guruITA/smart-city-sim/docs/tile objectives.md

# Tiles

## 1. City layout
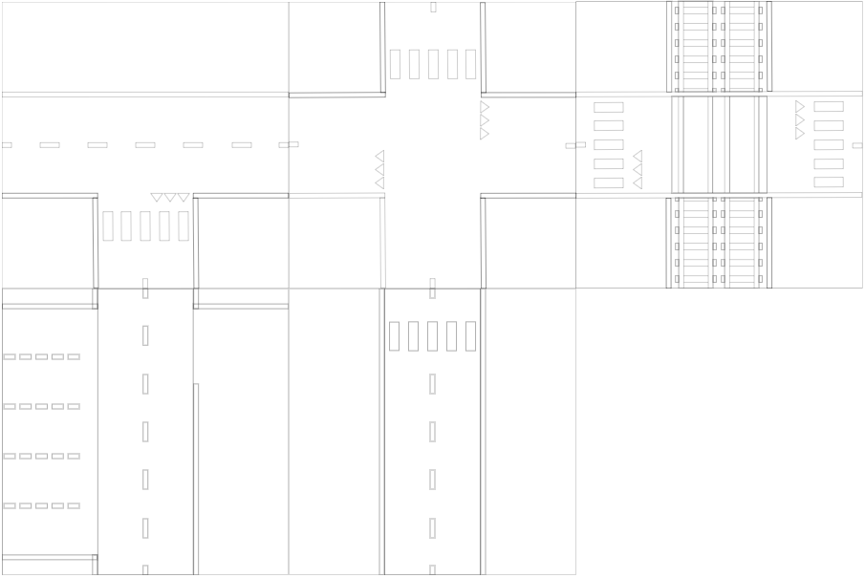
[picture p14: docs/assets/tiles city-layout.png]
City layout


---

## 2. Tile objectives
These will be the objectives everyone will focus on.

### sprint 1
- Thijmen - railroad crossing with barriers and warning lights 
- Gurpreet - Streetlights
- Wesley - Traffic lights
- Matin - Parking
- Betül - Pedestrian Light

---
