guruITA/smart-city-sim/docs/Thijmen/index.md

# Thijmen's vault

Indexes:

- [Blink RGB LED demo](./Blink%20RGB%20LED.md)

- [Blink 2 LEDS alternating demo](./Blink%202%20LEDS%20alternating.md)

- [Train prediction signal demo](./Train%20prediction%20signal%20demo.md)
