guruITA/smart-city-sim/docs/Matin/Sprint 2/Mayor Delivery.md

# Mayor Delivery - Sprint 2

## My Challenges

Deployed the backend on the Raspberry Pi (145.92.8.137) with production Docker setup, restart policies, and environment variables. Merged Thijmen's railroad crossing code into the shared backend (233 commits, 5 file-level merge conflicts resolved). Analyzed all team members' code for WiFi readiness and created a 3-phase integration plan. Backend grew to 15+ endpoints across 4 routers and 4 database tables.

## The City

Backend running on the Raspberry Pi, accessible on the HvA network. Railroad crossing tile fully integrated with dedicated database tables. Dashboard shows parking and railroad data live. Deployment script automates updates via SSH. The generic sensor readings table works for simple tiles, dedicated tables added for structured state (railroad crossing).

## Agreements Next Period

Put everything together in the city as a team. All tiles connected to the Pi, city should be complete.

## Learning Group Feedback

Mats said: I want to hear a story, the city should be done, no perfection needed, and surprise me.

## Personal Feedback

Focus on the backend and make sure the whole city works together as one system.

## Reflection

**What went well:** Pi deployment works, railroad crossing merged successfully, created an integration plan for the whole team.

**What can be improved:** Not all tiles connected yet. Portflow evidence was missing problem framing and learning goals, which caused the 1/4 score from Mats.

**What I take to the next sprint:** Technical work is invisible without a story. Next sprint: describe the problem first, then show the solution.
