guruITA/smart-city-sim/docs/Thijmen/Sprint 2/index.md

## Learning Question
How can I structure the train crossing functionality as reusable and mergeable code within one shared ESP32-S3 project, so that it can send train data to a backend and be integrated with other tiles in a clear, maintainable, and reliable way?

## Deliverables
1. [Analysis](./Analysis.md)
2. [Design](./Design.md)
3. [Realise](./Realise.md)
4. [Advice](./Advice.md)
