guruITA/smart-city-sim/docs/Thijmen/Sprint 3/index.md

## Learning Question
How can I add a screen to the ESP32 that shows the city’s name and logo, and make sure this information can be updated from the backend in a clear and reusable way?

## Deliverables
1. [Analysis](./Analysis.md)
2. [Design](./Design.md)
3. [Realise](./Realise.md)
4. [Advice](./Advice.md)
