guruITA/smart-city-sim/docs/Wesley/learning outcomes/sprint 3/Advice - Recognizing when a car is waiting at the traffic light and sending that information to the backend.md

# Advice - Recognizing when a car is waiting at the traffic light and sending that information to the backend

## Table of Contents

- [Introduction](#introduction)
- [Starting point](#starting-point)
- [Was my chosen solution suitable](#was-my-chosen-solution-suitable)
- [What worked well](#what-worked-well)
  - [1. The solution was simple enough to understand and test](#1-the-solution-was-simple-enough-to-understand-and-test)
  - [2. It fit well on top of my existing traffic-light prototype](#2-it-fit-well-on-top-of-my-existing-traffic-light-prototype)
  - [3. It helped me think in traffic states instead of raw inputs](#3-it-helped-me-think-in-traffic-states-instead-of-raw-inputs)
  - [4. It matched the broader smart-traffic direction of the project](#4-it-matched-the-broader-smart-traffic-direction-of-the-project)
- [What did not work as strongly](#what-did-not-work-as-strongly)
  - [1. It is only a simplified representation of a real road loop](#1-it-is-only-a-simplified-representation-of-a-real-road-loop)
  - [2. Sensor meaning still depends heavily on context](#2-sensor-meaning-still-depends-heavily-on-context)
  - [3. It can still be sensitive to placement](#3-it-can-still-be-sensitive-to-placement)
  - [4. It does not yet solve more advanced traffic situations](#4-it-does-not-yet-solve-more-advanced-traffic-situations)
- [Problems or limitations I found](#problems-or-limitations-i-found)
- [What I would advise for the next iteration](#what-i-would-advise-for-the-next-iteration)
  - [1. Keep the interpreted-state approach](#1-keep-the-interpreted-state-approach)
  - [2. Improve the physical placement and proof](#2-improve-the-physical-placement-and-proof)
  - [3. Add stronger validation rules in software](#3-add-stronger-validation-rules-in-software)
  - [4. Make the backend output easier to inspect](#4-make-the-backend-output-easier-to-inspect)
  - [5. Consider a more realistic traffic sensor later](#5-consider-a-more-realistic-traffic-sensor-later)
- [My final advice](#my-final-advice)
- [Conclusion](#conclusion)
- [References](#references)

## Introduction

In this advice document, I evaluate whether my chosen solution was suitable for recognizing when a car is waiting at the traffic light and sending that information to the backend.

For this learning goal, I chose to use the **KY-021 Mini Magnetic Reed Switch Module** as a simple prototype sensor. I used it to represent the function of a road loop in a simplified way. The goal of this step was not to build a full real-world traffic detection system yet, but to prove that my project can detect a traffic situation, interpret it correctly, and pass that interpreted result to the backend.

This advice builds on the wider project direction that a traffic light becomes smart when it starts reacting to real-time input instead of only following a fixed cycle. The broader second-iteration requirements already define that the system must detect vehicles, use that input in traffic-light decisions, and fall back safely if no valid input is available. 

## Starting point

Before this learning goal, I already had a working first traffic-light prototype. The first iteration already gave me a stable base with the ESP32-S3, the three traffic-light outputs, fixed phase timing, safe startup in red, and a clear implementation flow from analysis to design to realization.  The earlier Fritzing work also showed that documenting the hardware design clearly made later building and checking easier. 

That was important, because it meant I did not have to solve everything at once. I could extend an already working traffic-light system with one new smart input.

## Was my chosen solution suitable

Yes, for this iteration I think my chosen solution was suitable.

The KY-021 was a good prototype choice because it let me focus on the most important learning result of this goal:

* noticing that something is happening at the stop line
* deciding whether that means waiting traffic or not
* sending that interpreted state to the backend

For this step, I did not yet need a complex sensor. I needed a sensor that was simple enough to wire, simple enough to read, and clear enough to test. The KY-021 gave me that.

So as a **prototype learning solution**, it was suitable.

## What worked well

### 1. The solution was simple enough to understand and test

The KY-021 works with a simple digital signal. That made it easier to connect to the ESP32-S3 and easier to reason about in software. For this learning goal, that simplicity was helpful, because I wanted to focus on the interpretation logic rather than on complicated sensor calibration.

### 2. It fit well on top of my existing traffic-light prototype

Because the first iteration already worked physically and logically, I could use that earlier prototype as the base and only add the new sensor flow. That made the step realistic and manageable instead of too large at once. The earlier implementation already proved that my hardware base and traffic-light sequence were stable enough to build on. 

### 3. It helped me think in traffic states instead of raw inputs

This was the strongest part of the solution. The real learning was not that the pin can become active. The real learning was that the same sensor trigger can mean different things depending on the traffic-light phase.

Because of that, this learning goal pushed me to work with interpreted states such as:

* no vehicle
* waiting vehicle
* passing vehicle
* unclear input

That is a more useful system design than only sending raw sensor values to the backend.

### 4. It matched the broader smart-traffic direction of the project

The wider project already says that smart behavior begins when the system uses sensor input as part of traffic-light decisions. This solution fits that direction, because it is the first step where the traffic light starts responding to something happening on the road instead of only following a timer. 

## What did not work as strongly

Even though the solution was suitable for this iteration, it also has limitations.

### 1. It is only a simplified representation of a real road loop

The KY-021 is useful as a prototype stand-in, but it is not the same as a real inductive loop in a road. It depends on a magnet and a reed-switch trigger, while a real traffic loop works in a very different physical way.

That means the solution is good for learning and prototyping, but not realistic enough to claim that it fully represents real traffic detection.

### 2. Sensor meaning still depends heavily on context

The KY-021 alone does not know whether a car is waiting. It only knows whether the magnet is present. The actual meaning has to be created in software by combining:

* sensor state
* signal duration
* traffic-light phase

That means the hardware alone is not enough. The quality of the result depends strongly on the interpretation logic.

### 3. It can still be sensitive to placement

The meaning of the signal depends a lot on where the sensor is placed. If it is too early, too late, or not aligned well with the car position, it can produce a trigger that does not really represent a waiting car.

So even though the sensor is simple, correct placement is still important.

### 4. It does not yet solve more advanced traffic situations

This solution is still limited to one simple question:

**is there a waiting car here or not**

It does not yet tell me:

* how many cars are waiting
* how long the queue is
* how fast traffic is moving
* whether traffic density is increasing
* whether there are multiple vehicles in one lane

So it is a useful first smart step, but not yet a complete smart-traffic solution.

## Problems or limitations I found

The main limitation I found is that a sensor trigger by itself is not enough to describe the traffic situation clearly.

The hardest part was not detecting presence, but preventing wrong interpretation. The most important example is this:

* during red, a stable trigger can mean a waiting car
* during green, a short trigger can simply mean a passing car

That means the project can easily give the wrong answer if the sensor signal is treated too simply.

A second limitation is that the backend only becomes useful if it receives interpreted information. Sending only active or inactive would not be strong enough, because the backend would still need to guess what the signal means.

## What I would advise for the next iteration

### 1. Keep the interpreted-state approach

This is something I would definitely keep.

I would continue to send states like:

* waiting
* passing
* no vehicle
* unclear

instead of only sending raw sensor values. That makes the backend clearer and makes the whole project more understandable.

### 2. Improve the physical placement and proof

In the next iteration, I would pay even more attention to the exact stop-line position of the sensor and to the physical proof of that position in Fritzing and in the real build.

The earlier Fritzing work already showed me that good documentation improves clarity and traceability. For the next version, that will matter even more because the sensor position affects the meaning of the result. 

### 3. Add stronger validation rules in software

In a next iteration, I would improve the logic for deciding when a signal is stable enough and when it should be treated as unclear. That would reduce the risk of short, accidental, or badly timed triggers being treated as real waiting traffic.

### 4. Make the backend output easier to inspect

The backend part worked conceptually, but in a next iteration I would make the output even easier to review. For example, I would log:

* phase
* interpreted state
* time of change
* validity of the reading

That would make debugging and later analysis easier.

### 5. Consider a more realistic traffic sensor later

For this learning goal, the KY-021 was a good prototype choice. But if I want to make the system more realistic later, I should eventually look at a sensor that better matches real road detection behavior. That would make the smart part of the traffic light closer to real-world traffic systems.

## My final advice

If I had to advise myself or another student doing the same kind of project, I would say this:

Start with a simple sensor solution if the goal is to learn how the traffic light should **interpret** traffic input, not to perfectly copy real-world hardware immediately.

The KY-021 is suitable for that purpose because it keeps the setup simple and testable. But do not mistake a simple trigger for a complete traffic answer. The real value comes from combining the signal with the traffic-light phase and turning it into a meaningful state for the backend.

So my advice is:

* use a simple sensor first
* focus on interpretation logic
* keep safety and fallback behavior central
* document the hardware clearly
* improve realism only in later iterations

## Conclusion

Looking back at this learning goal, I think my chosen solution was suitable for the stage of the project I am in now.

The KY-021 was not the perfect real-world traffic sensor, but it was a good prototype choice because it allowed me to prove the most important step: my traffic-light project can move from fixed behavior to sensor-informed behavior.

The strongest part of the solution was not the sensor itself, but the decision to interpret the signal in context and send that interpreted result to the backend.

So my final conclusion is:

**For this iteration, the KY-021 was a suitable prototype solution because it was simple enough to build and test, while still allowing me to learn the more important skill of interpreting traffic input correctly and using it safely in the system.**

## References

Wesley. *Smart Traffic Light - When Does a Traffic Light Become Smart.* Used as the broader project source for second-iteration vehicle-detection requirements, smart-traffic direction, acceptance criteria, and safe fallback behavior. 

Wesley. *Traffic Light - first iteration - implementation.* Used as proof that the earlier ESP32-S3 traffic-light base was already working and suitable to extend with sensor-based behavior. 

Wesley. *Traffic Light - first iterion - fritzing.* Used as reference for the value of clear hardware documentation and traceability in the project workflow.
