guruITA/smart-city-sim/docs/Wesley/learning goals/sprint 2/Sprint 2, Learning Goal 1 - Expanding the traffic-light system to multiple traffic lights v2.md

# Sprint 2 — Learning Goal 1: Expanding the traffic-light system to multiple traffic lights

## Learning Question

How can I turn my first simple traffic light into a small crossroads system with multiple traffic lights that work together safely and clearly?

## S — Situation

At the start of Sprint 2, I already have one working traffic light. I built it with an ESP32-S3, three LEDs, and one resistor for each LED. The system starts safely on red, changes in a fixed order from red to green to yellow, and repeats that cycle correctly. I tested it in simulation and on real hardware, so I know the first version works.

That first version helped me understand the basics: how to connect the lights, how to control them, and how to make sure the system stays safe by never turning on conflicting lights at the same time. Right now, the setup only represents one traffic light. That is fine for learning the basics, but it does not yet reflect a real traffic situation. A real crossroads has more than one traffic light, and those lights must work together.

In this sprint, I want to take the next step by expanding my project from one traffic light to multiple traffic lights. The reason is practical: traffic lights are not useful on their own at a crossroads. They need to be coordinated so road users can clearly understand when they must stop and when they may go. If that coordination is wrong, the situation becomes confusing or unsafe. By adding multiple traffic lights, I move from a simple demo to a more realistic traffic situation.

## T — Task

For this learning goal, my task is to turn my first working traffic light into a small crossroads system with multiple traffic lights that can work together properly. The purpose of this step is not only to add more lights, but to make sure the full situation remains understandable and safe. I want to solve the practical problem that one traffic light on its own does not yet show how traffic control works in a real environment.

To do that, I will first work out what the expanded system needs to do and what rules it has to follow. After that, I will design how the traffic lights should be connected and how they should take turns. I will then build and test the setup, first on the breadboard and later in the project tile. During that process, I will check whether the lights work together in a logical way and whether unsafe combinations are prevented. The goal is to create a working multi-traffic-light system that is not only technically correct, but also makes sense from the perspective of real traffic use.

### Deliverables

1. Analysis document

In this document, I explain what I am adding in this second version of the project and what the crossroads system should do in practice. I describe the most important safety rules that the system has to follow so that the traffic lights work together in a clear and safe way. I also explain what I see as a correct result for this step and which limits I still have in my current hardware setup.

2. Design document

In this document, I show how the multiple traffic lights are connected and which pins and components I use for the full setup. I explain how the traffic lights are grouped and how they take turns during the traffic cycle. I also include a diagram or table that makes clear how the full system works as one coordinated setup.

3. Realisation document

In this document, I record how I first build the setup on a breadboard and how I test whether the traffic lights work together correctly. I describe how I transfer the working setup into the project tile and which code I use to control the different traffic lights. I also show the test results that prove the system works safely and as intended.

4. Advice document

In this document, I evaluate whether the system is easy to understand and whether the chosen structure is good enough for the next sprint. I reflect on the problems or limitations I ran into during this step and explain what I would improve before continuing with smarter behaviour in a later iteration.

## A — Action

I worked on this learning goal in four clear steps.

First, I made the **analysis deliverable**. In that document, I examined how I could expand my first simple traffic light into a four-way crossing with multiple traffic lights, while still keeping the system understandable, safe, and suitable for later extension. I compared possible approaches and chose the direction with an **ESP32-S3, MCP23017, two ULN2803 chips, and external LED power**, because that structure uses fewer controller pins, avoids multiplexing, and leaves room for later sensors and backend control.

After that, I made the **design deliverable**. In that document, I translated the analysis into a concrete design for the crossroads system. I worked out the grouping of the traffic lights into **North/South** and **East/West**, defined the coordinated traffic cycle, described the channel mapping, and documented the full hardware structure from controller to lamp output. I also made clear how the design stays safe by preventing conflicting green states and by using all-red transition phases.

Next, I worked on the **realisation phase**. I first used staged tests during building, starting with serial communication, then I2C communication, then standalone testing of the MCP23017, standalone testing of the ULN2803, and then the combined signal path. After that, I built the full four-way setup on the breadboard and tested whether the system started safely, followed the correct sequence, avoided conflicting green states, and cycled stably. In this phase, I also improved the software by replacing `delay()` with a `millis()` based state machine so the code is more suitable for later integration with other parts of the project.

Finally, I made the **advice deliverable**. In that document, I looked back on the choices I made and described what I should keep for the next sprint. My advice was to keep the current hardware architecture, keep the simplified crossroads model, continue with the `millis()` based approach, keep testing in stages, and add only one smart feature first in the next iteration.
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
