guruITA/smart-city-sim/docs/Wesley/learning outcomes/sprint 2/Advice — Learning Goal 1 - Expanding the traffic-light system to multiple traffic lights.md

# Advice — Learning Goal 1 - Expanding the traffic-light system to multiple traffic lights

## Table of Contents

- [1. Introduction](#1-introduction)
- [2. Advice based on this sprint](#2-advice-based-on-this-sprint)
  - [2.1 I should keep the current hardware structure](#21-i-should-keep-the-current-hardware-structure)
  - [2.2 I should keep the simplified crossroads model](#22-i-should-keep-the-simplified-crossroads-model)
  - [2.3 I should keep the `millis()` based state machine](#23-i-should-keep-the-millis-based-state-machine)
  - [2.4 I should make the software more modular before adding too much new behaviour](#24-i-should-make-the-software-more-modular-before-adding-too-much-new-behaviour)
  - [2.5 I should freeze one final mapping before continuing](#25-i-should-freeze-one-final-mapping-before-continuing)
  - [2.6 I should add only one smart feature first](#26-i-should-add-only-one-smart-feature-first)
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
