guruITA/smart-city-sim/docs/Betül/images/nietbeveiligd-docs-swagger.png

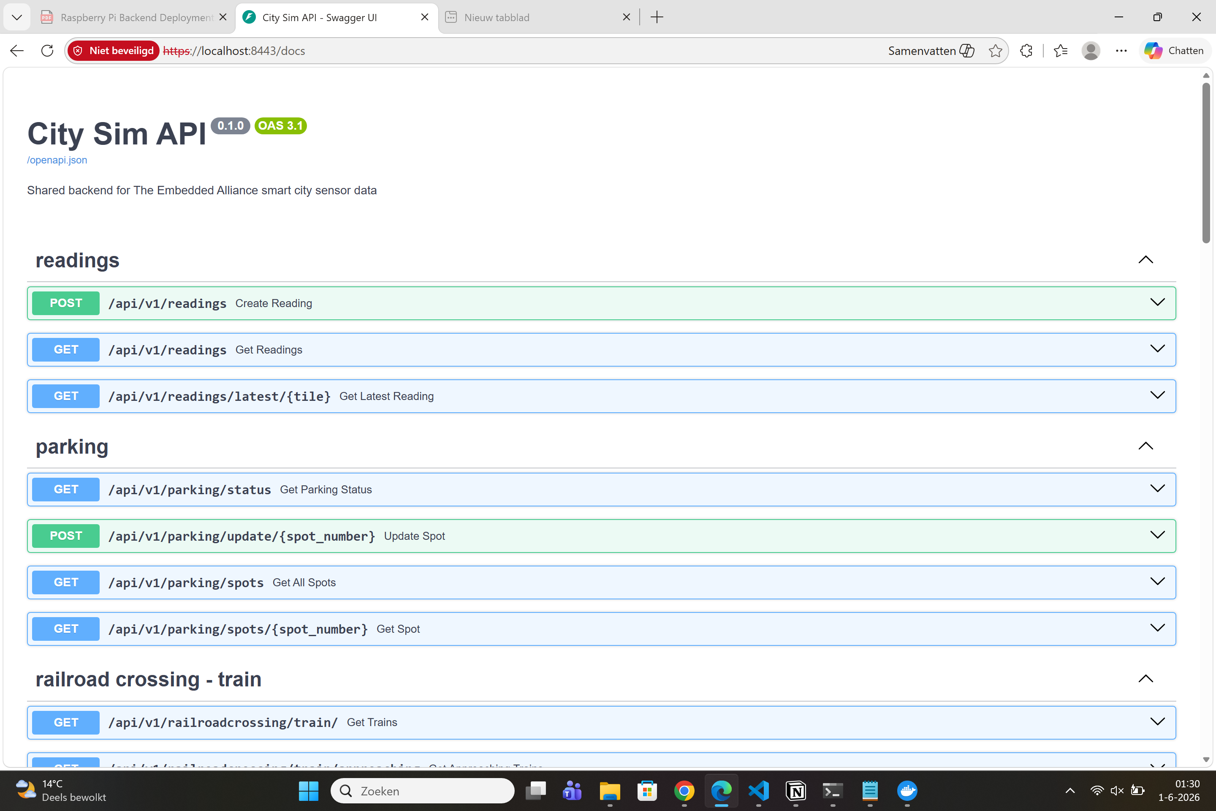
docs/Betül/images/nietbeveiligd-docs-swagger.png
