guruITA/smart-city-sim/docs/Betül/images/nietbeveiligd.png

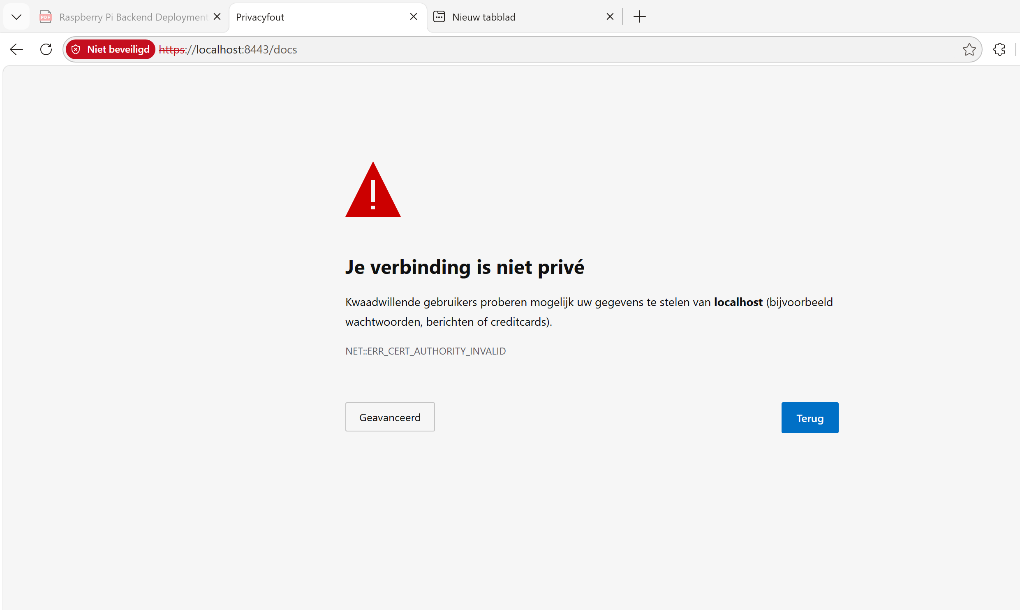
docs/Betül/images/nietbeveiligd.png
