guruITA/smart-city-sim/docs/Gurpreet/Learning goals/Analysis/Sprint 1/Proof/images/ohms_law_for_capacitor.png

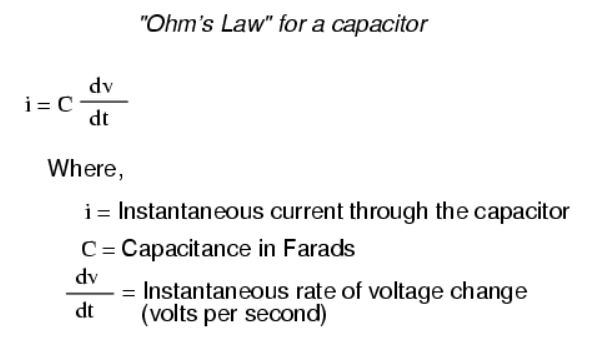
docs/Gurpreet/Learning goals/Analysis/Sprint 1/Proof/images/ohms_law_for_capacitor.png
