guruITA/smart-city-sim/docs/Gurpreet/Learning goals/Design/Sprint 2/Proof/images/UML_diagram.png

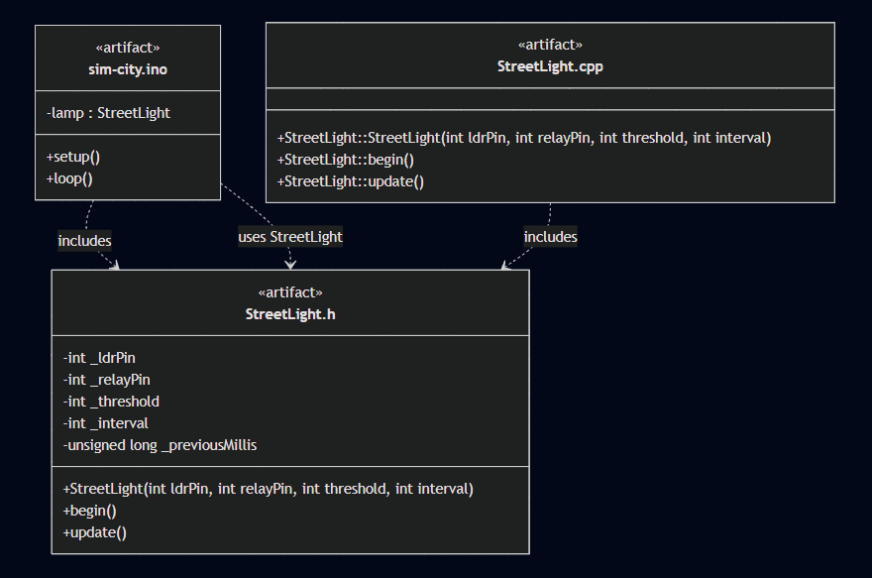
docs/Gurpreet/Learning goals/Design/Sprint 2/Proof/images/UML_diagram.png
