guruITA/smart-city-sim/docs/Gurpreet/Learning goals/Learning journey/Sprint 1/Proof/images/5v_relay_module_current_estimate.png

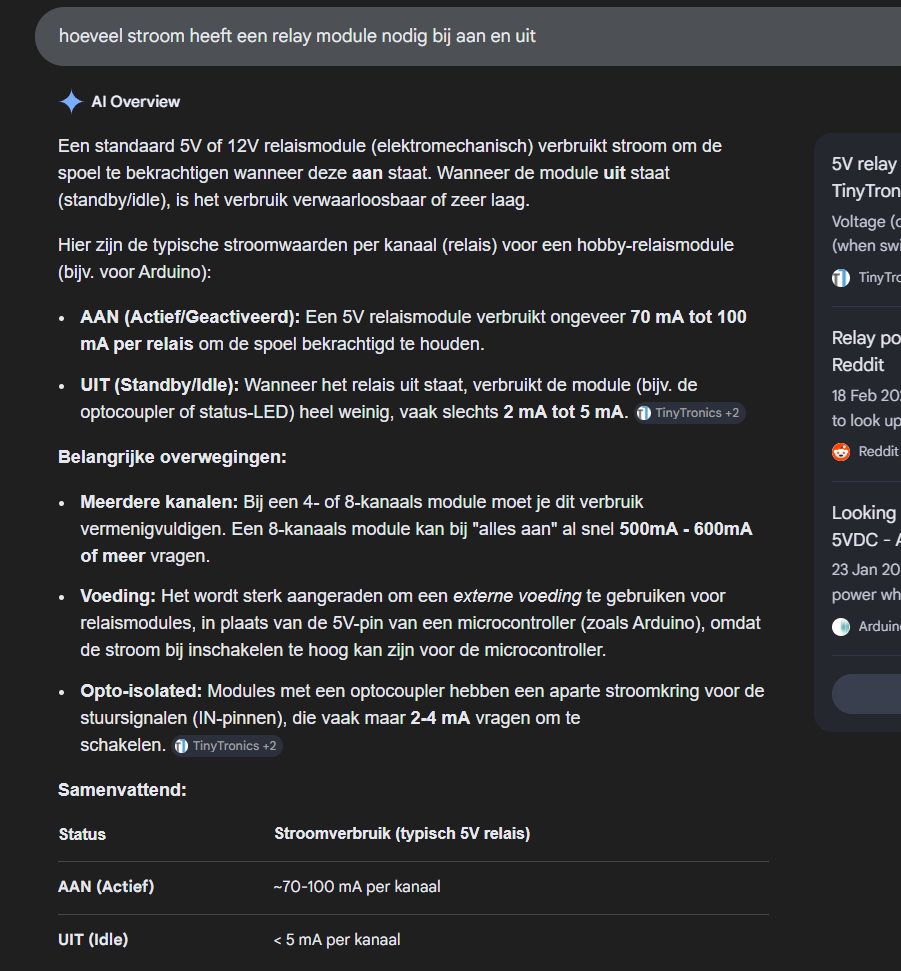
docs/Gurpreet/Learning goals/Learning journey/Sprint 1/Proof/images/5v_relay_module_current_estimate.png
