guruITA/smart-city-sim/docs/Gurpreet/Learning goals/Learning journey/Sprint 1/Proof/images/breadboard_power_supply_specs.png

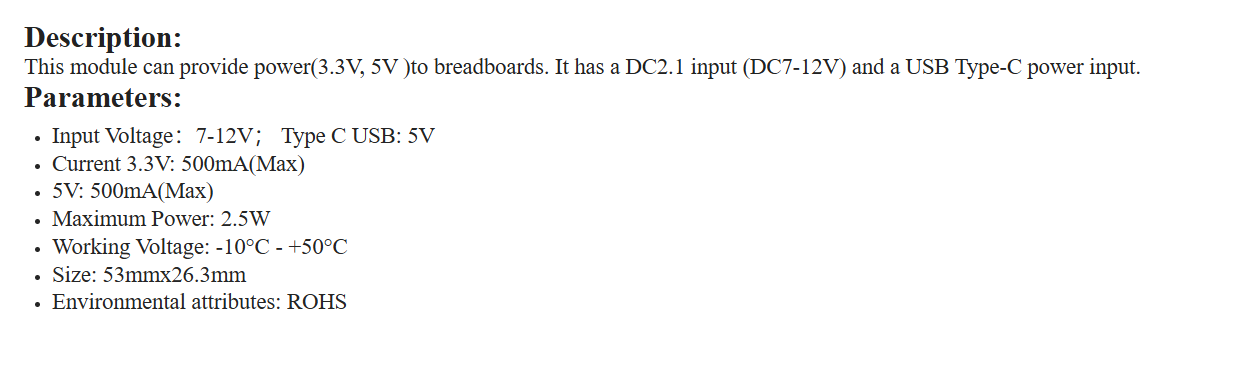
docs/Gurpreet/Learning goals/Learning journey/Sprint 1/Proof/images/breadboard_power_supply_specs.png
