guruITA/smart-city-sim/docs/Gurpreet/Learning goals/Learning journey/Sprint 1/Proof/images/ESP32_S3_gpio_max_current_vs_usb_supply.png

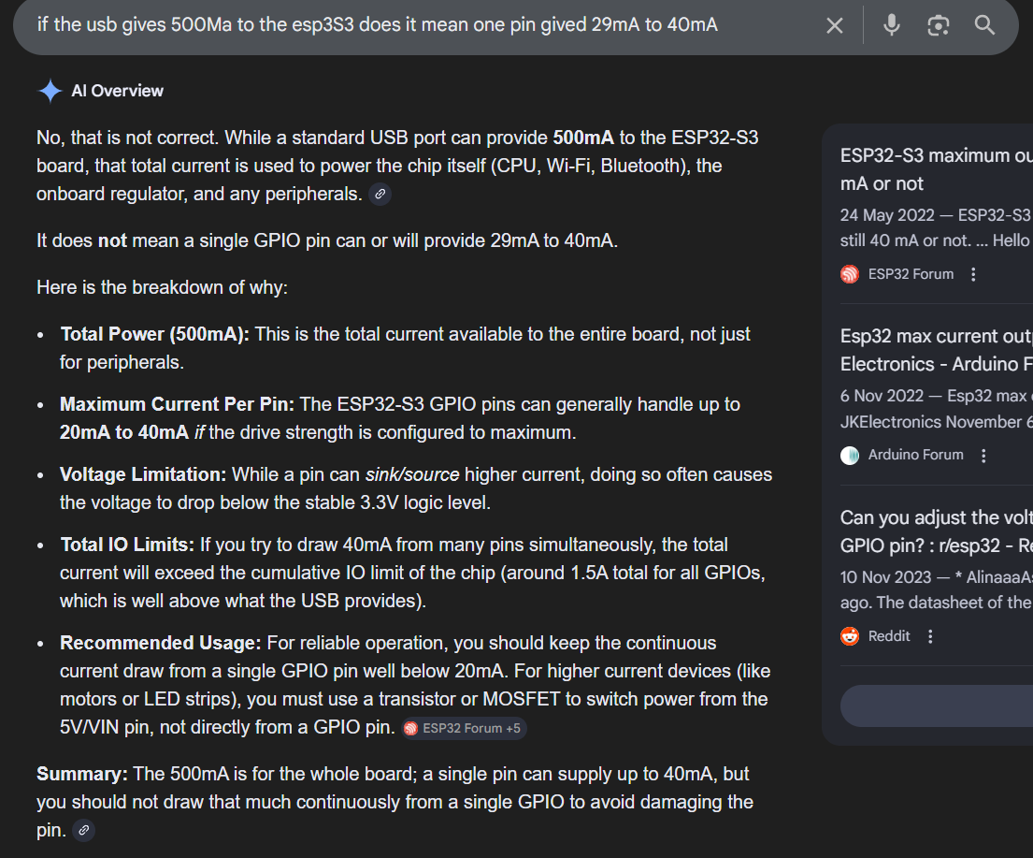
docs/Gurpreet/Learning goals/Learning journey/Sprint 1/Proof/images/ESP32_S3_gpio_max_current_vs_usb_supply.png
