guruITA/smart-city-sim/docs/Gurpreet/Learning goals/Learning journey/Sprint 1/Proof/images/ESP32_S3_no_wifi_current_estimate_1.png

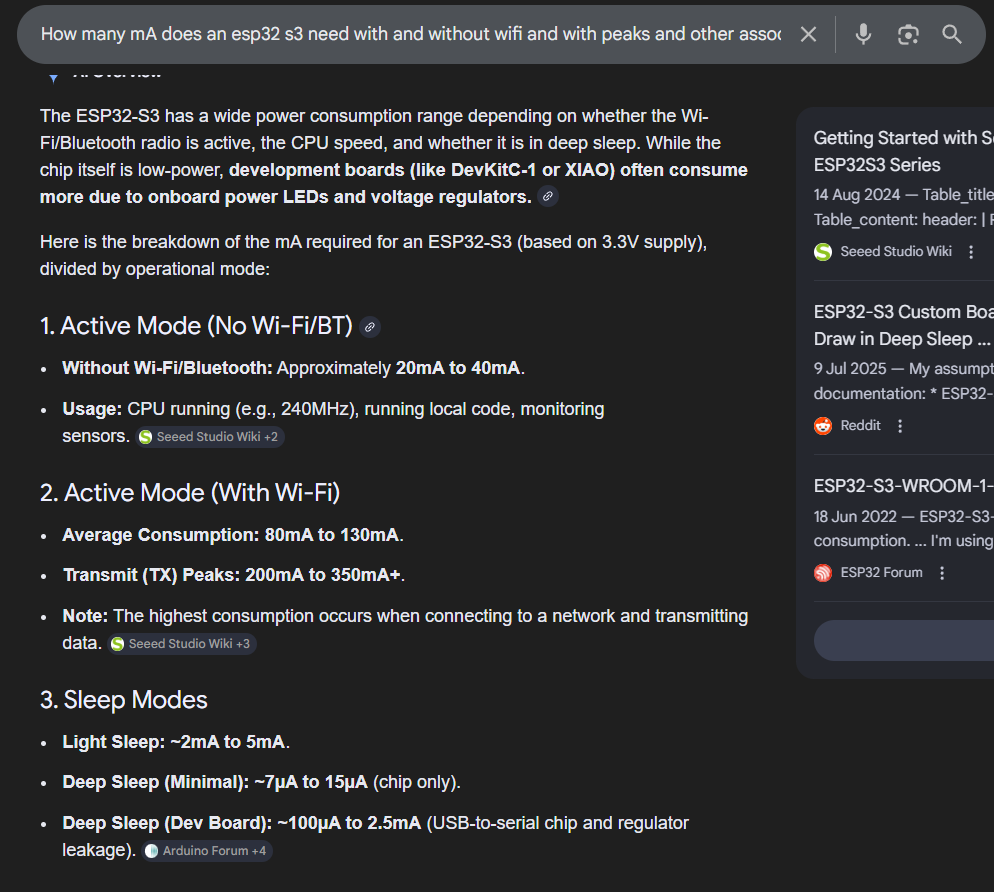
docs/Gurpreet/Learning goals/Learning journey/Sprint 1/Proof/images/ESP32_S3_no_wifi_current_estimate_1.png
