guruITA/smart-city-sim/docs/Gurpreet/Learning goals/Learning journey/Sprint 1/Proof/images/esp32s3_gpio_pin_restrictions_summary.png

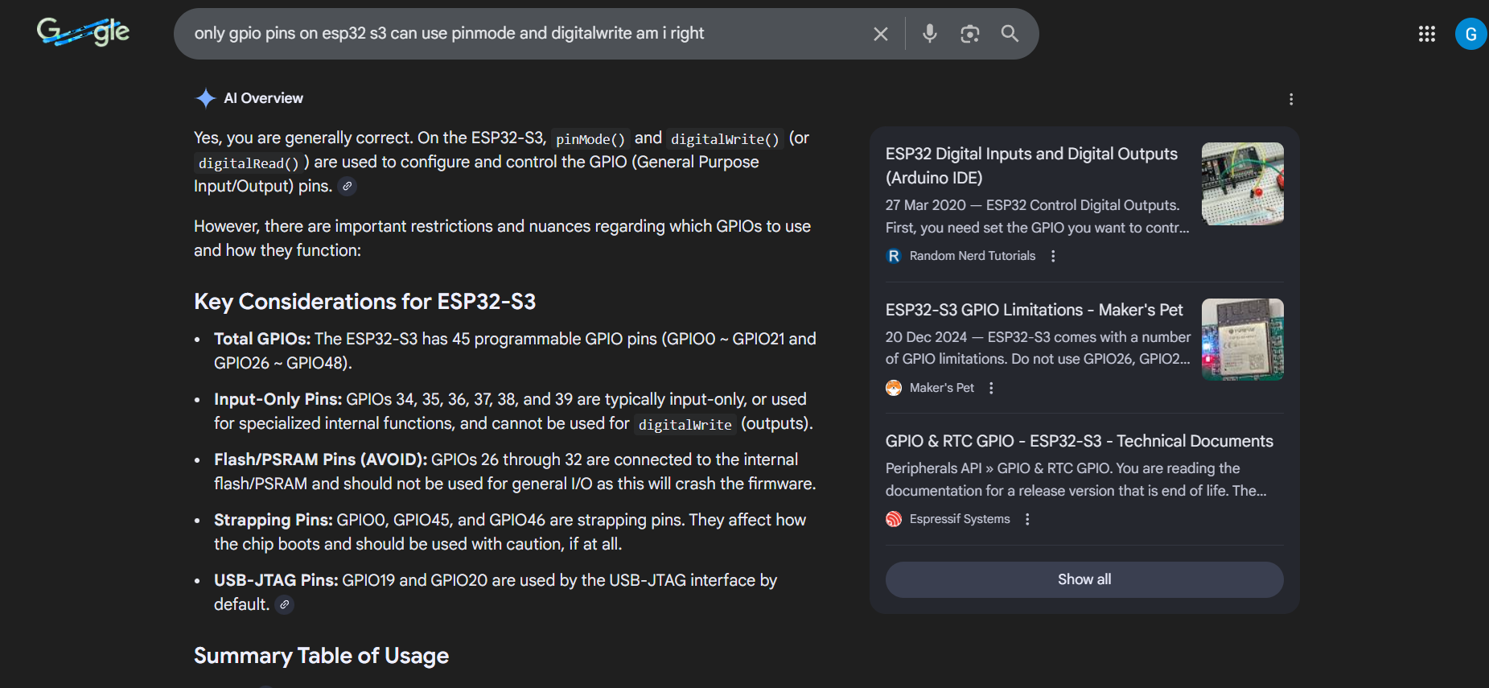
docs/Gurpreet/Learning goals/Learning journey/Sprint 1/Proof/images/esp32s3_gpio_pin_restrictions_summary.png
