guruITA/smart-city-sim/docs/Gurpreet/Learning goals/Learning journey/Sprint 1/Proof/images/github_ESP32_S3_DevKitC1-clone.png

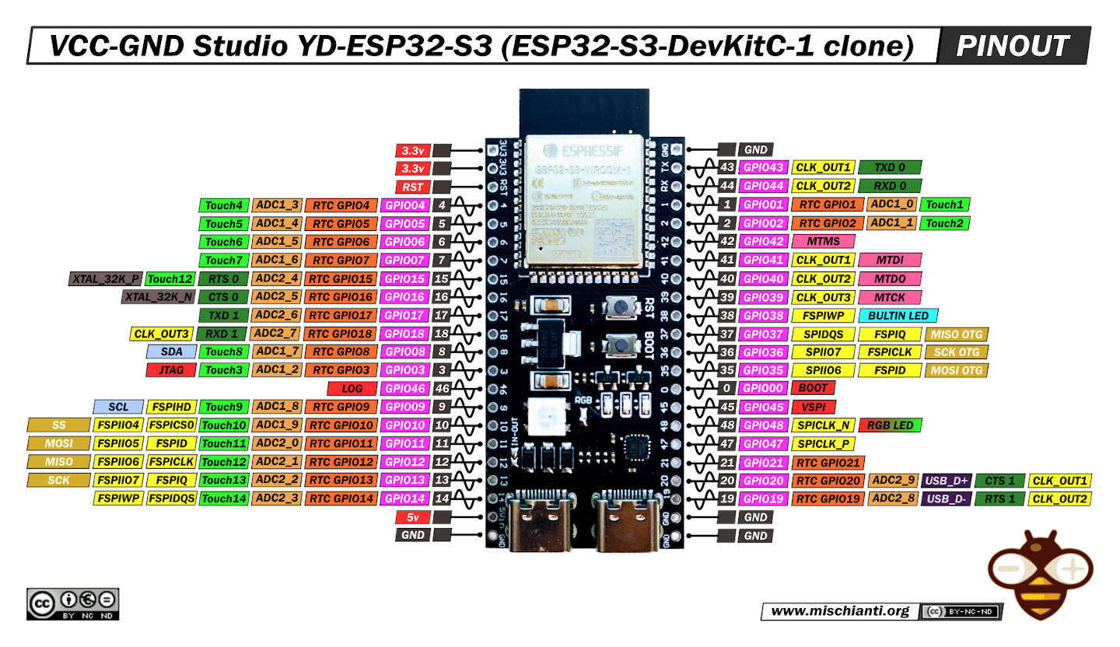
docs/Gurpreet/Learning goals/Learning journey/Sprint 1/Proof/images/github_ESP32_S3_DevKitC1-clone.png
