guruITA/smart-city-sim/docs/Gurpreet/Learning goals/Learning journey/Sprint 1/Proof/images/ldr_ao_to_adc_pin_explanation.png

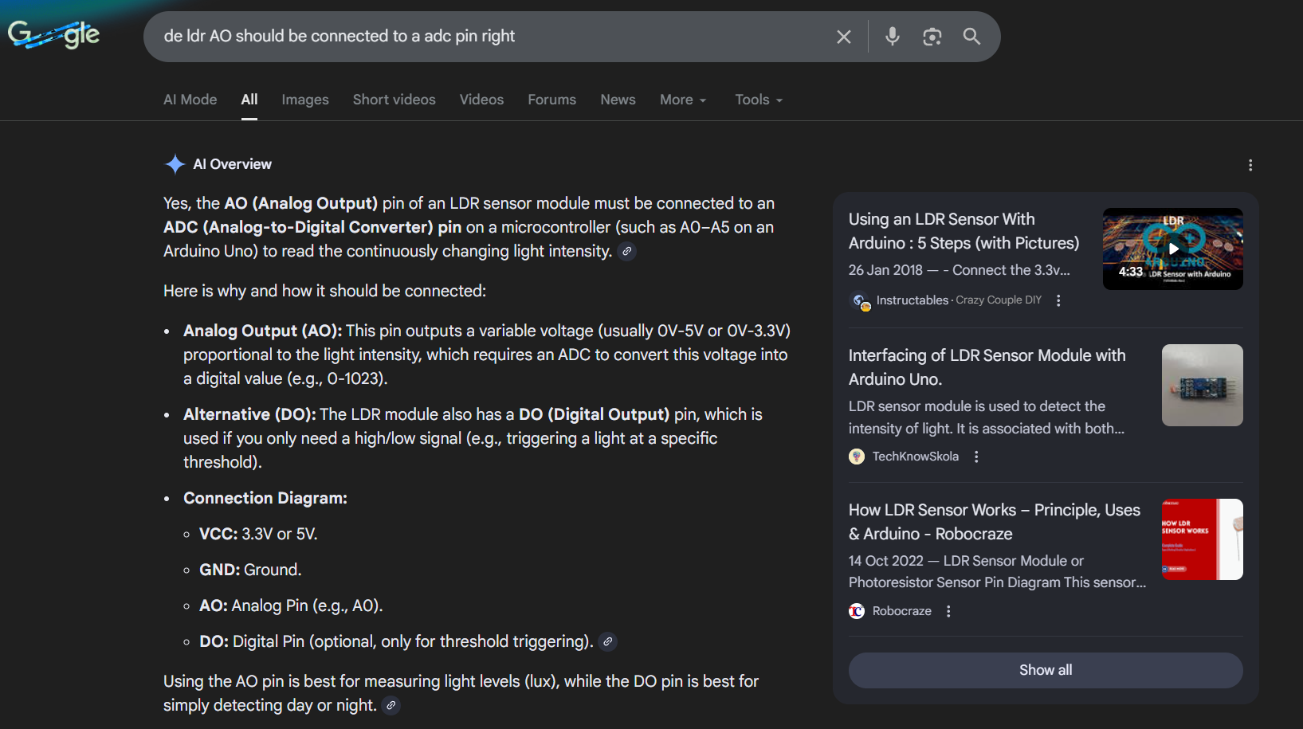
docs/Gurpreet/Learning goals/Learning journey/Sprint 1/Proof/images/ldr_ao_to_adc_pin_explanation.png
