guruITA/smart-city-sim/docs/Gurpreet/Learning goals/Learning journey/Sprint 1/Proof/images/streetlight_schematic_fritzing.png

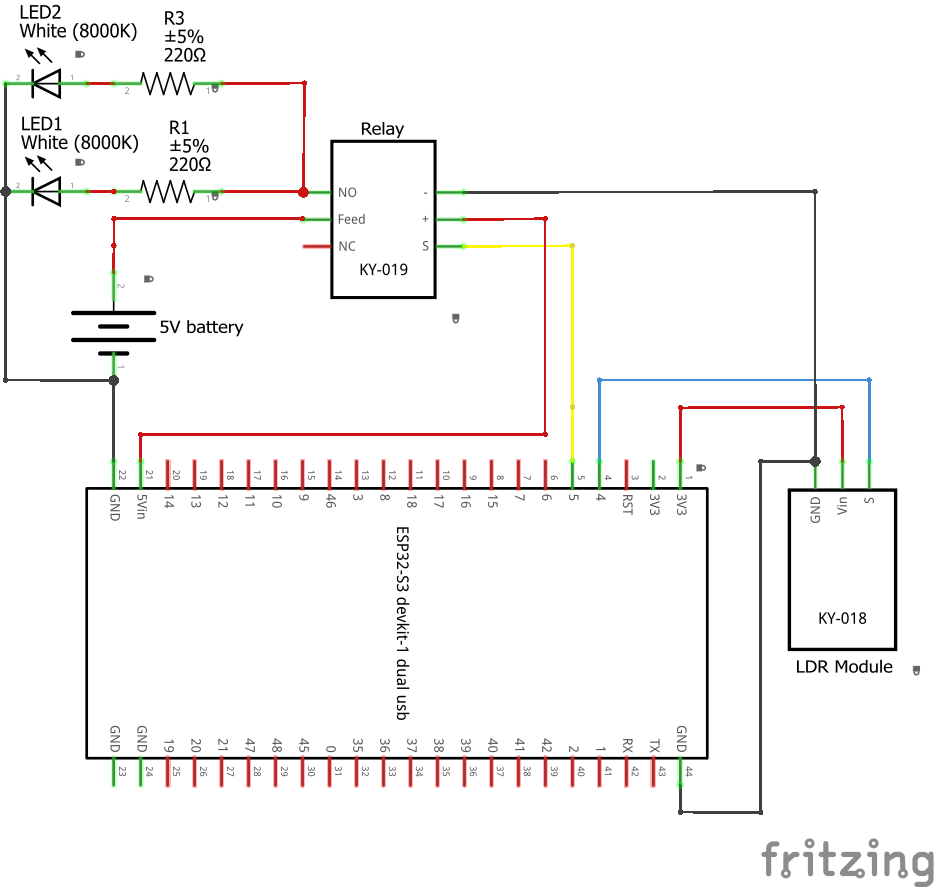
docs/Gurpreet/Learning goals/Learning journey/Sprint 1/Proof/images/streetlight_schematic_fritzing.png
