guruITA/smart-city-sim/docs/Gurpreet/Learning goals/Learning journey/Sprint 1/Proof/images/wokwi_streetlight_schema.png

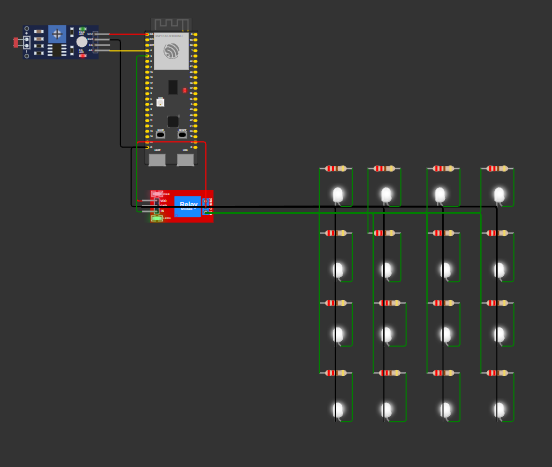
docs/Gurpreet/Learning goals/Learning journey/Sprint 1/Proof/images/wokwi_streetlight_schema.png
