guruITA/smart-city-sim/docs/Gurpreet/Learning goals/Realise/Sprint 1/Proof/images/smart_streetlight_working_prototype.jpeg

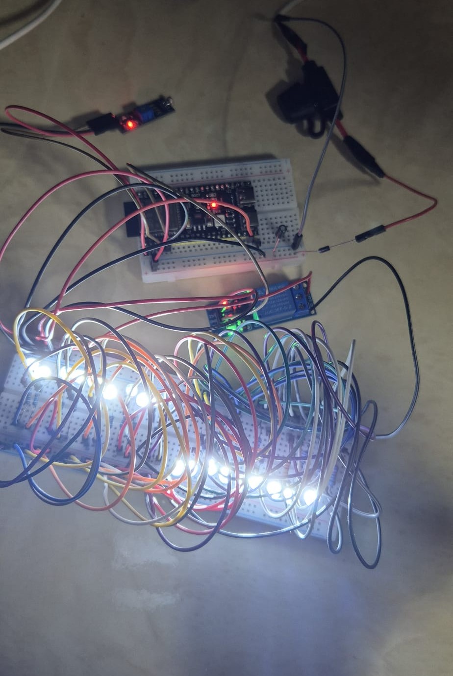
docs/Gurpreet/Learning goals/Realise/Sprint 1/Proof/images/smart_streetlight_working_prototype.jpeg
