guruITA/smart-city-sim/docs/Matin/Sprint 1/Mayor1.jpeg

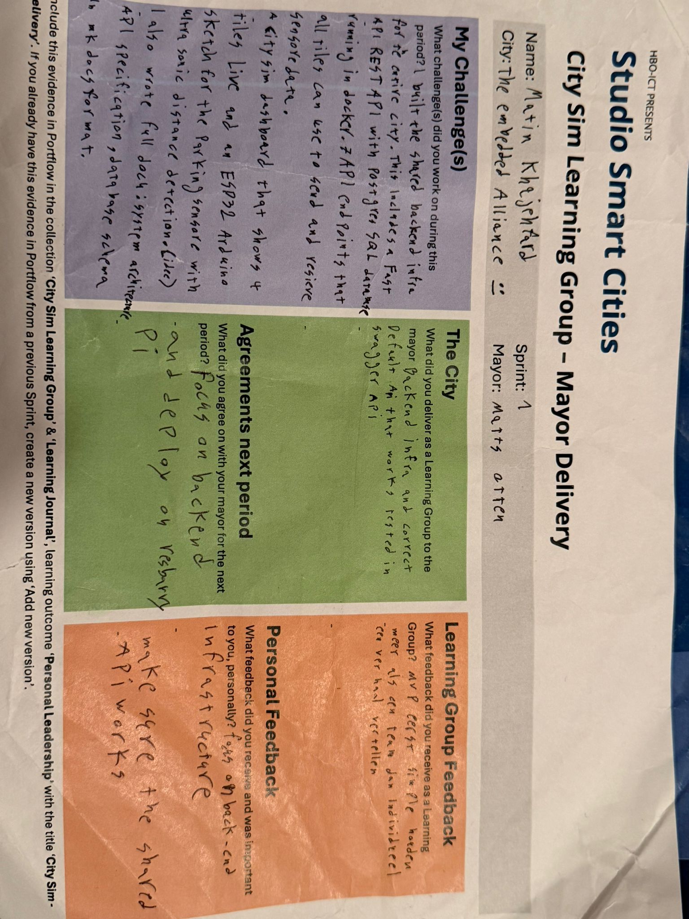
docs/Matin/Sprint 1/Mayor1.jpeg
