guruITA/smart-city-sim/docs/Matin/Sprint 2/Mayor2.jpeg

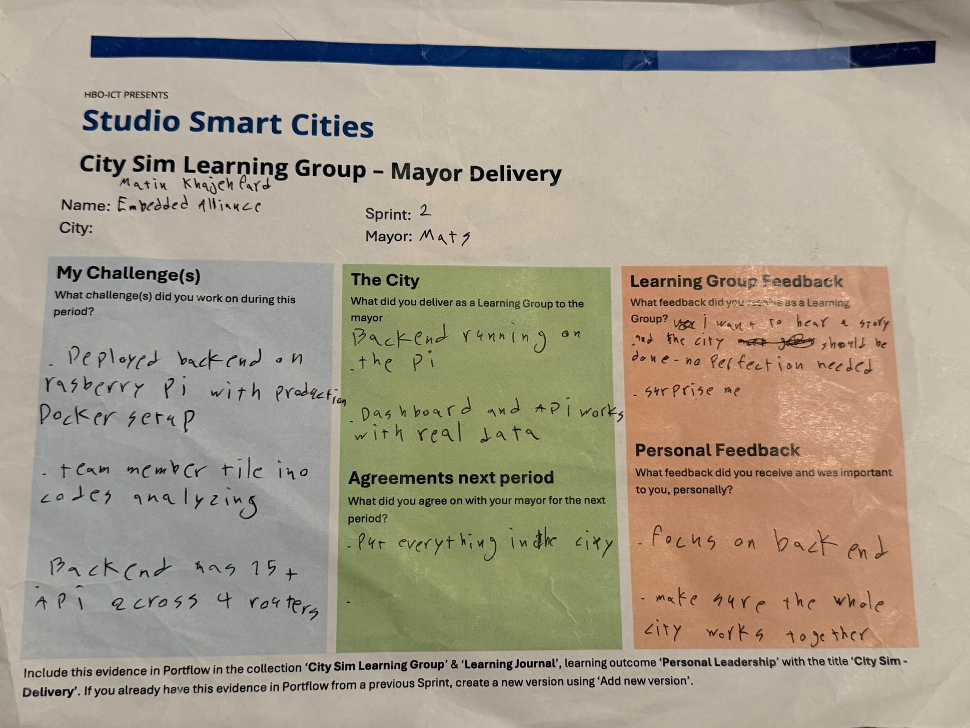
docs/Matin/Sprint 2/Mayor2.jpeg
