guruITA/smart-city-sim/docs/Matin/Sprint 3/Mayor3.jpeg

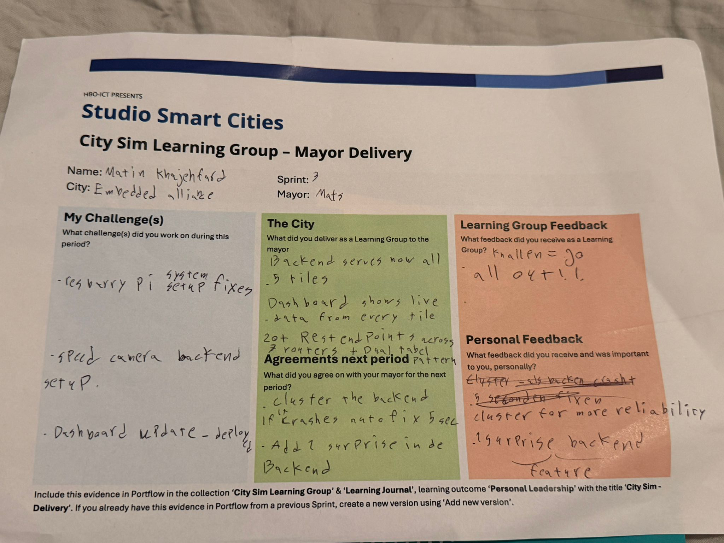
docs/Matin/Sprint 3/Mayor3.jpeg
