guruITA/smart-city-sim/docs/Matin/Sprint 4/backupFlow.png

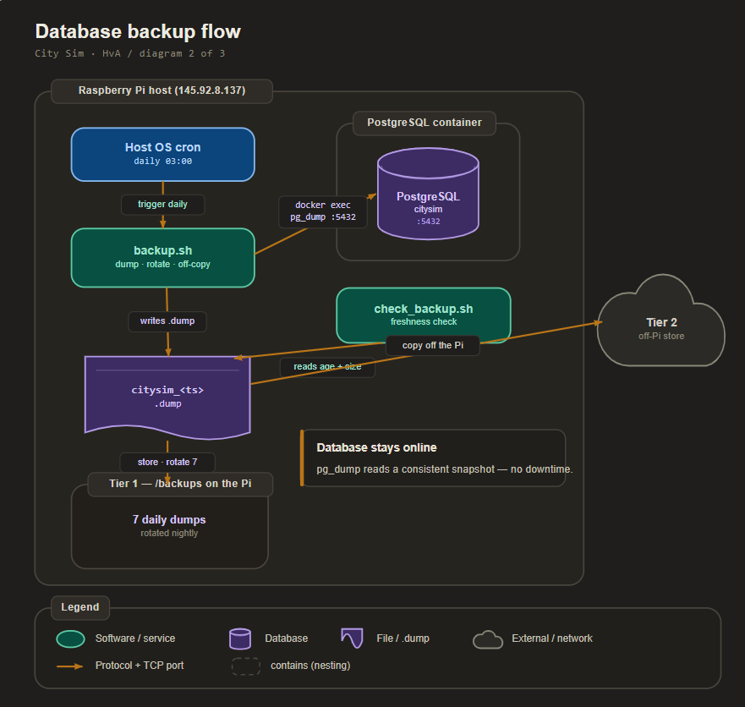
docs/Matin/Sprint 4/backupFlow.png
