guruITA/smart-city-sim/docs/Matin/Sprint 4/emergencyOverride.png

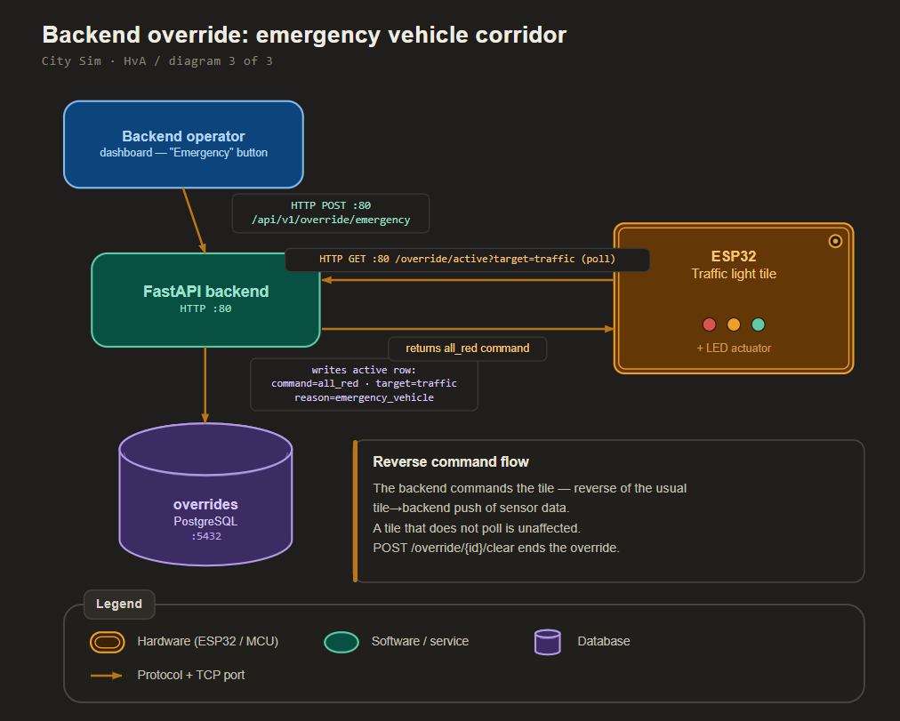
docs/Matin/Sprint 4/emergencyOverride.png
