guruITA/smart-city-sim/docs/Matin/Sprint 4/failoverTopology.png

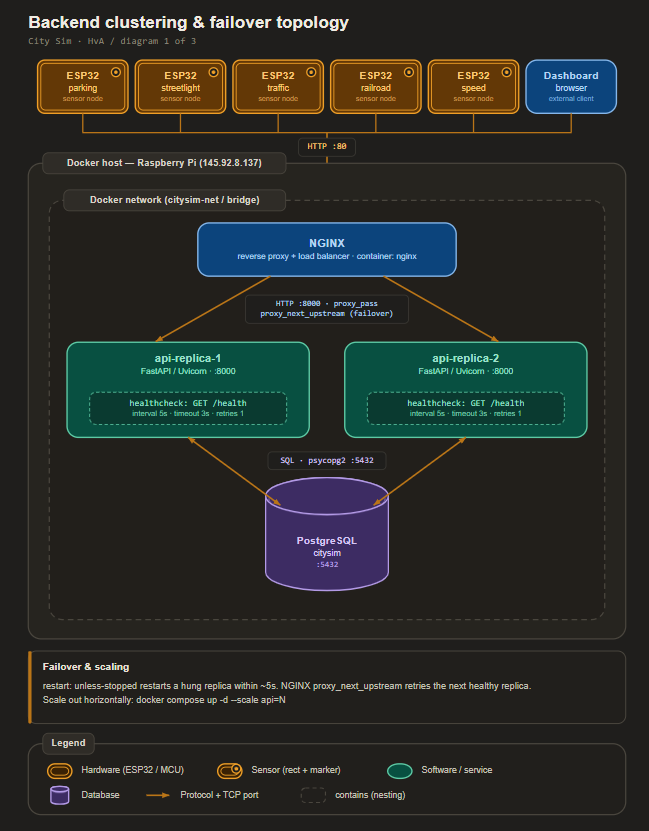
docs/Matin/Sprint 4/failoverTopology.png
