guruITA/smart-city-sim/docs/Thijmen/Sprint 2/assets/architecture.png

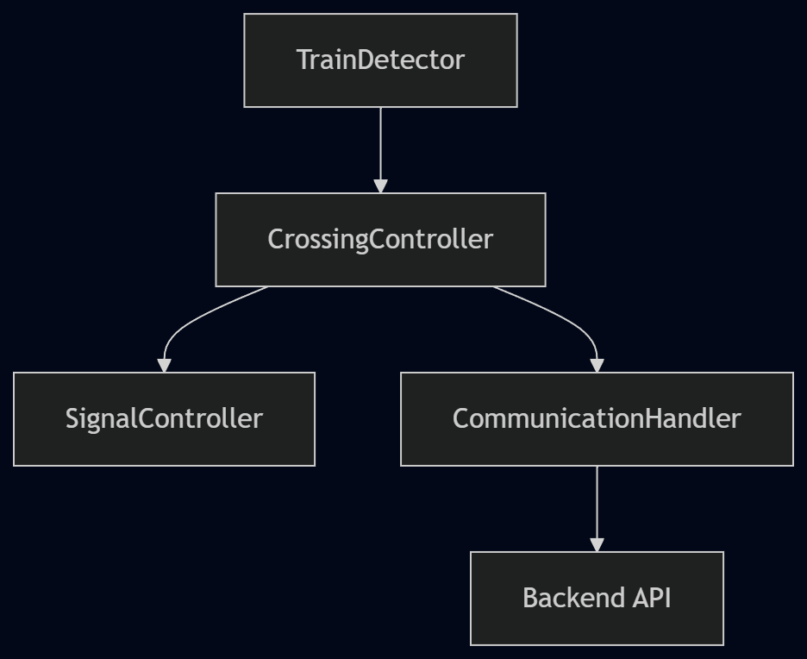
docs/Thijmen/Sprint 2/assets/architecture.png
