guruITA/smart-city-sim/docs/Thijmen/Sprint 2/assets/Library structure.png

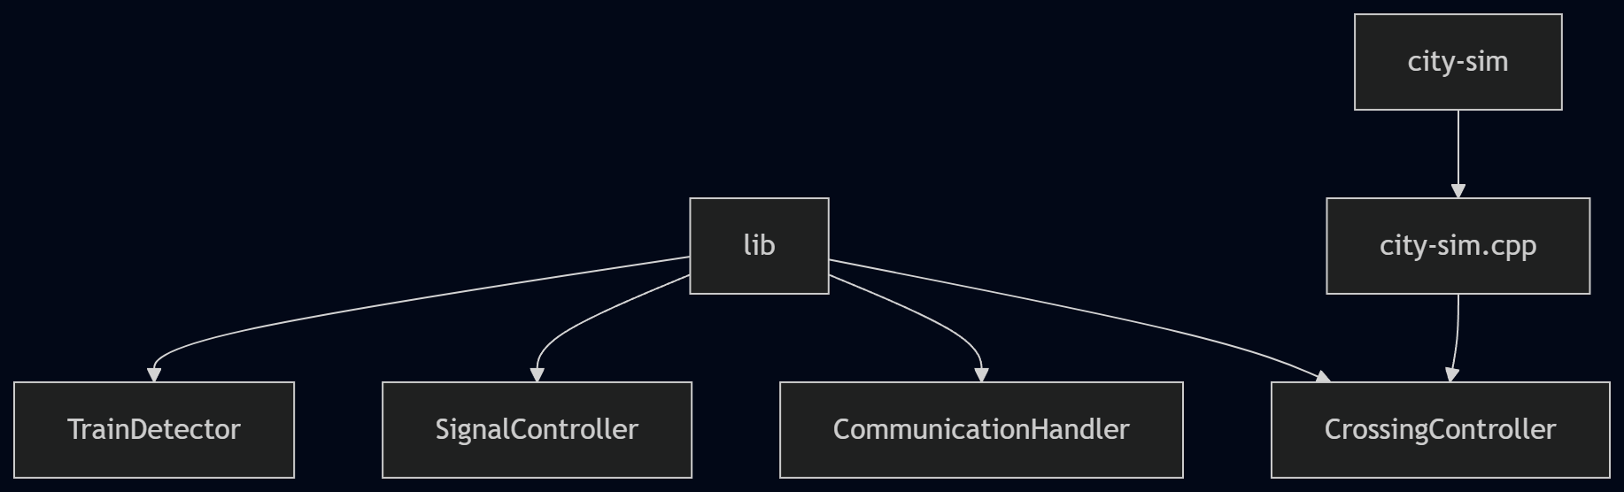
docs/Thijmen/Sprint 2/assets/Library structure.png
