guruITA/smart-city-sim/docs/Thijmen/Sprint 2/assets/Multi-Tile Integration.png

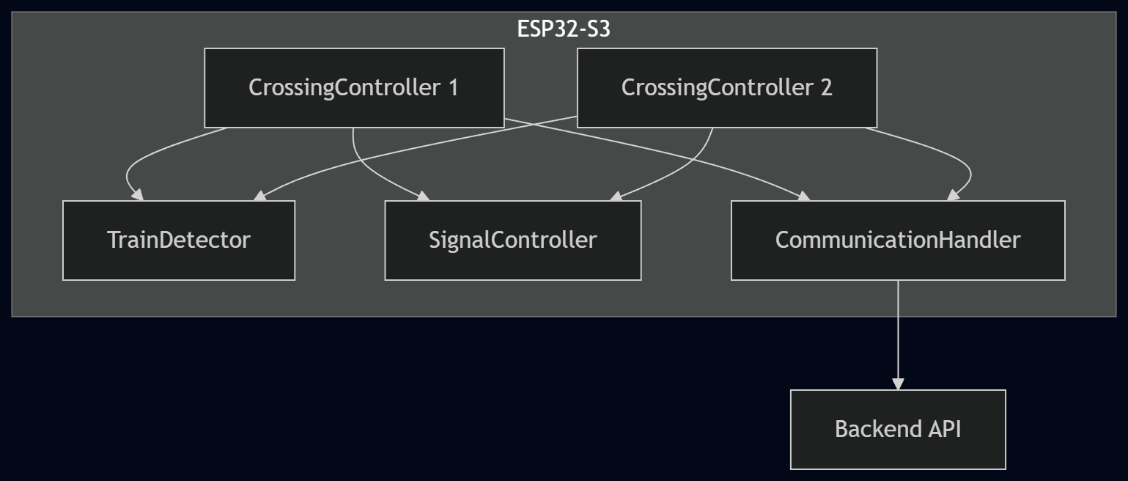
docs/Thijmen/Sprint 2/assets/Multi-Tile Integration.png
