guruITA/smart-city-sim/docs/Thijmen/Sprint 2/assets/Sequence diagram.png

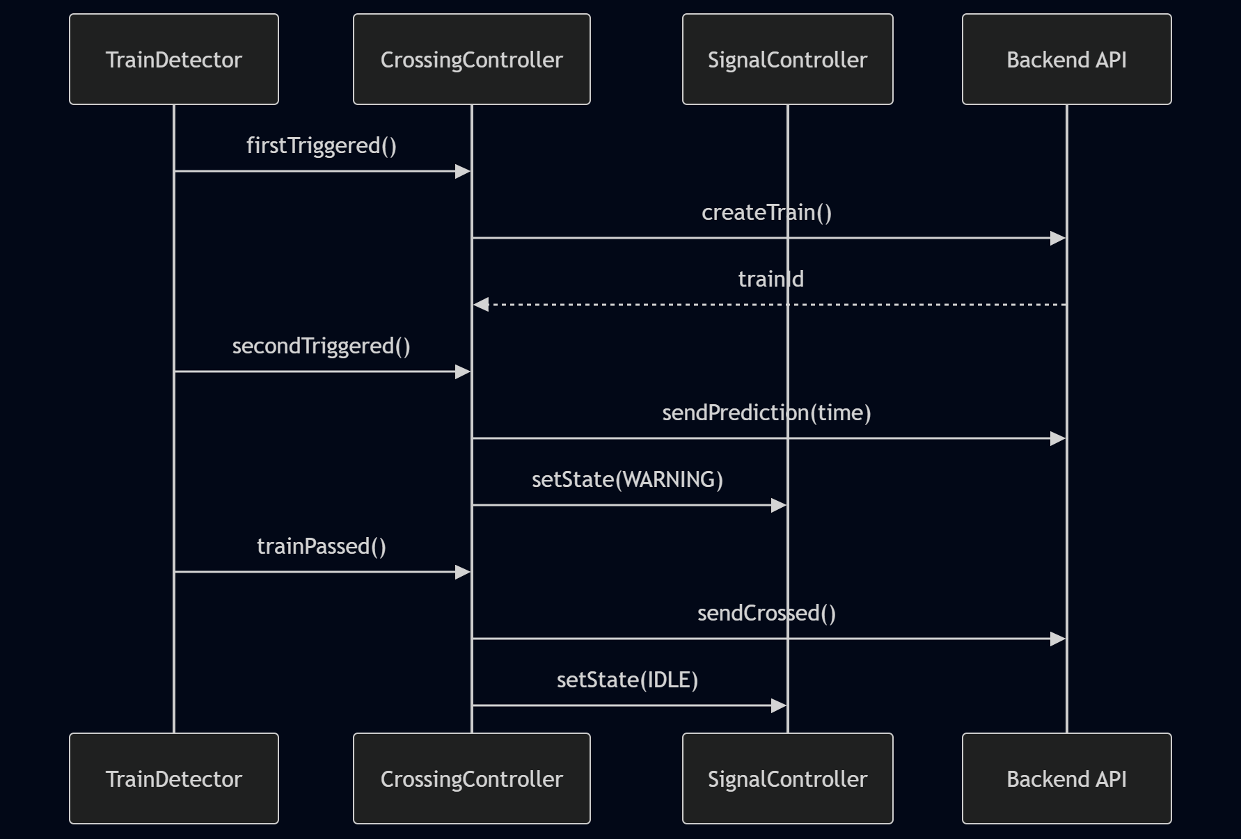
docs/Thijmen/Sprint 2/assets/Sequence diagram.png
