guruITA/smart-city-sim/docs/Thijmen/Sprint 2/assets/UML Class Diagram.png

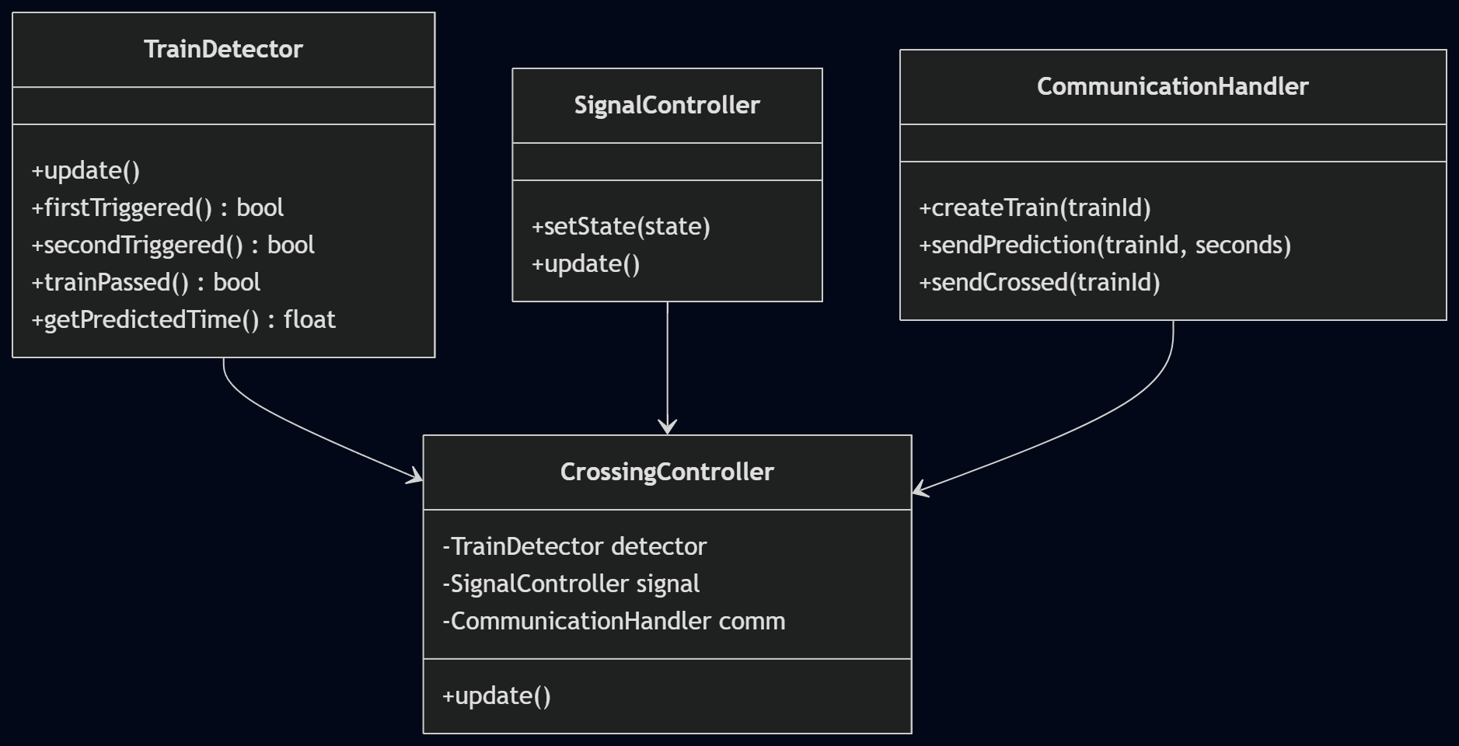
docs/Thijmen/Sprint 2/assets/UML Class Diagram.png
