guruITA/smart-city-sim/docs/Thijmen/Sprint 3/assets/E-ink-screen-fritzing.png

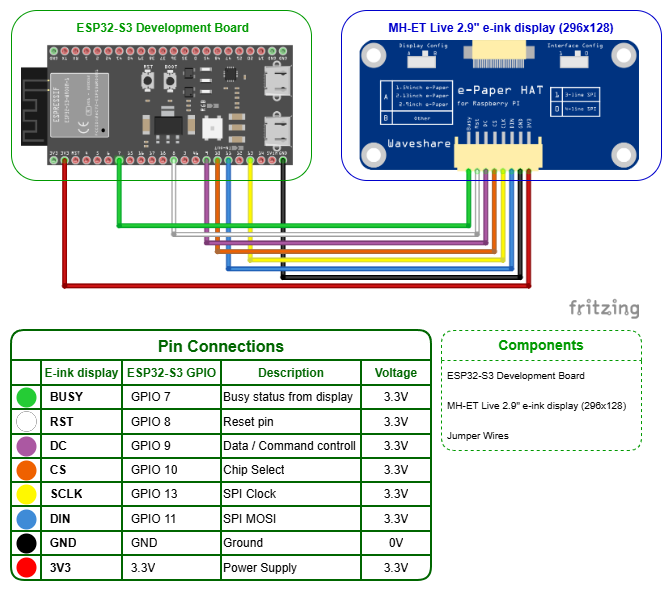
docs/Thijmen/Sprint 3/assets/E-ink-screen-fritzing.png
