guruITA/smart-city-sim/docs/Wesley/assets/ESP32-S3 Development Board - Pinout, Interfaces, and Practical Board Comparison/appendix_figureA1_pin_tables.png

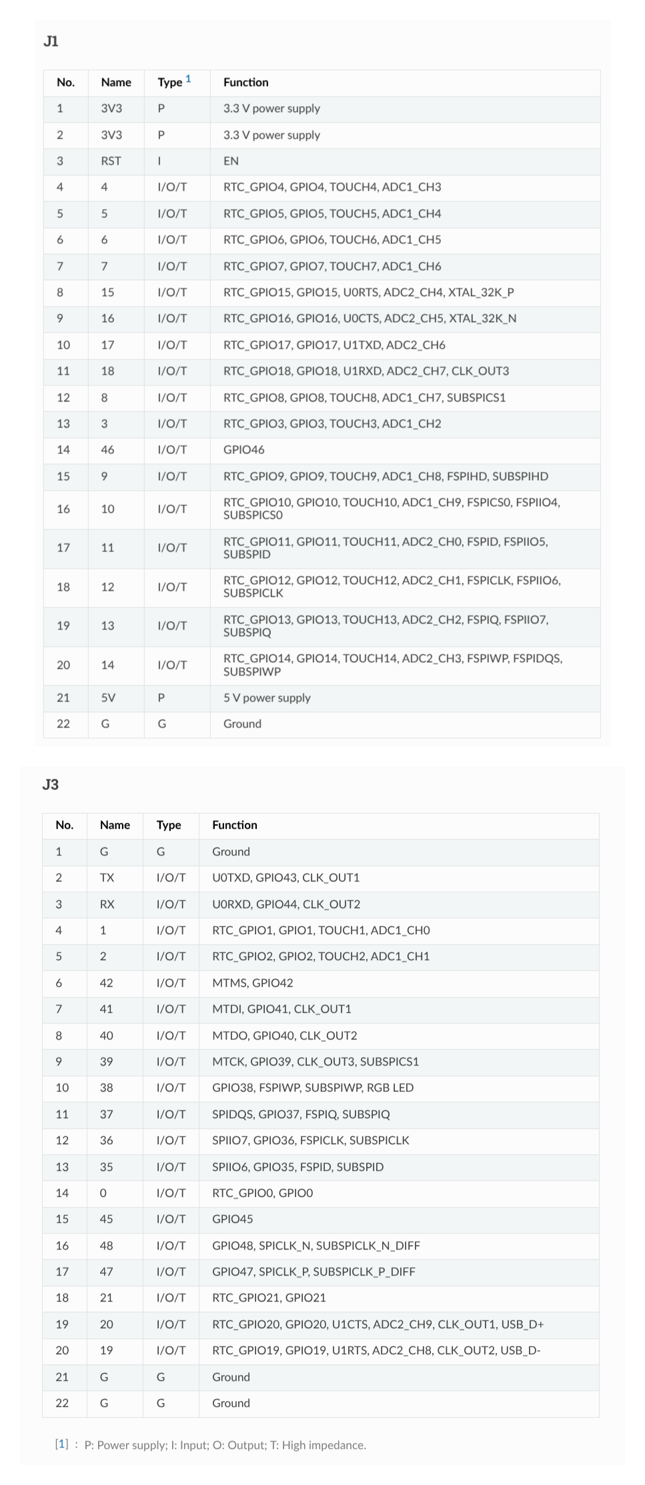
docs/Wesley/assets/ESP32-S3 Development Board - Pinout, Interfaces, and Practical Board Comparison/appendix_figureA1_pin_tables.png
