guruITA/smart-city-sim/docs/Wesley/assets/ESP32-S3 Development Board - Pinout, Interfaces, and Practical Board Comparison/figure03_pin_labels.png

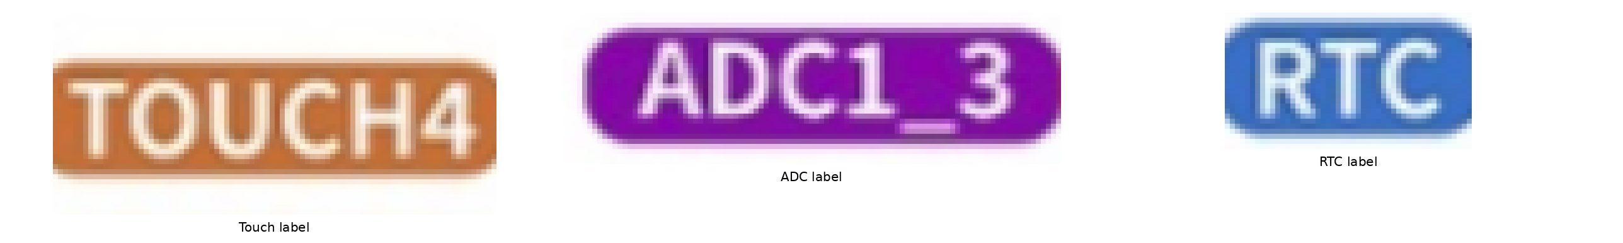
docs/Wesley/assets/ESP32-S3 Development Board - Pinout, Interfaces, and Practical Board Comparison/figure03_pin_labels.png
