guruITA/smart-city-sim/docs/Wesley/assets/ESP32-S3 Development Board - Pinout, Interfaces, and Practical Board Comparison/figure05_class_board_photo.png

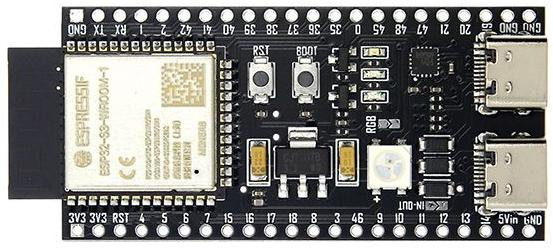
docs/Wesley/assets/ESP32-S3 Development Board - Pinout, Interfaces, and Practical Board Comparison/figure05_class_board_photo.png
