guruITA/smart-city-sim/docs/Wesley/assets/Traffic Light - first iteration - implementation/20260325_180750.jpg

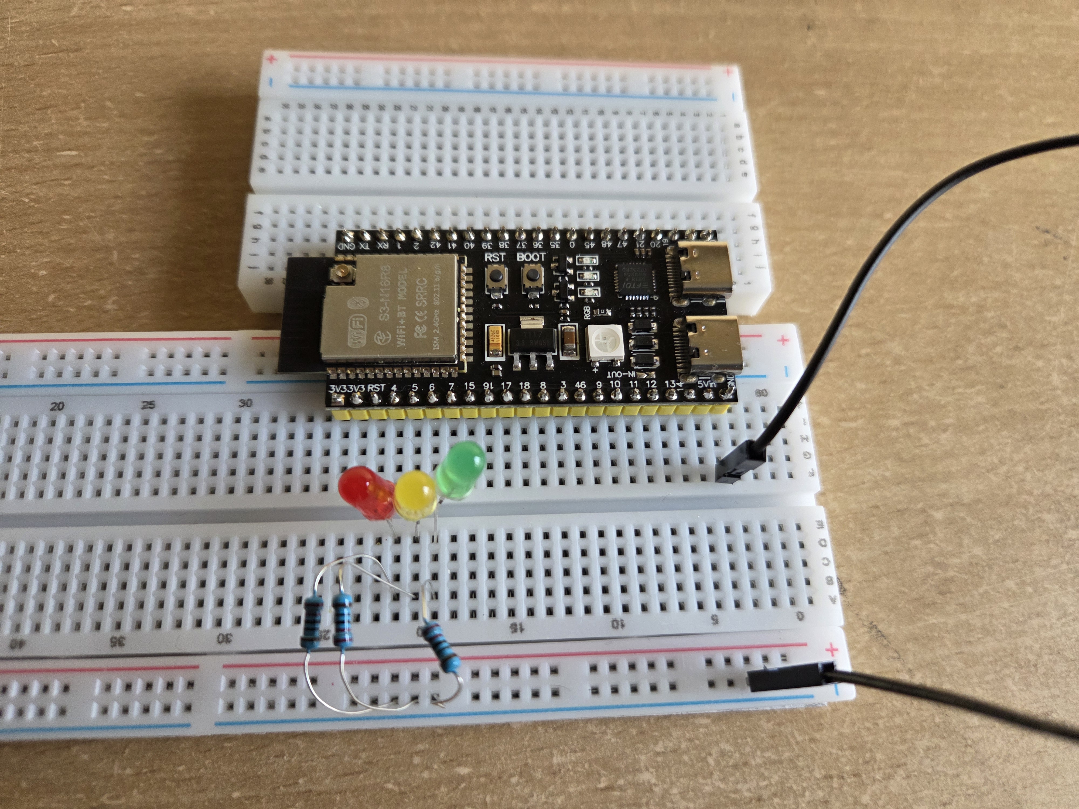
docs/Wesley/assets/Traffic Light - first iteration - implementation/20260325_180750.jpg
