guruITA/smart-city-sim/docs/Wesley/assets/Traffic Light - first iteration - wokwi/wokwi traffic light - first iteration.png

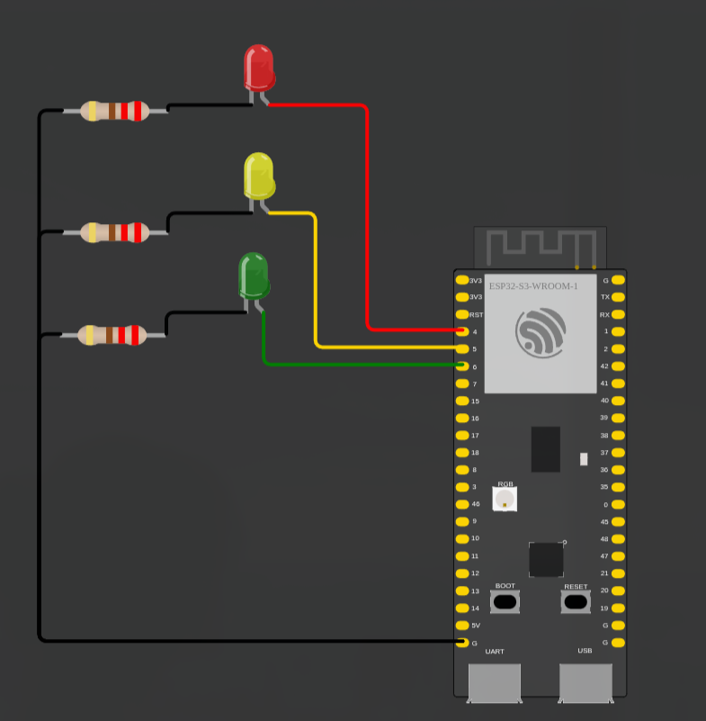
docs/Wesley/assets/Traffic Light - first iteration - wokwi/wokwi traffic light - first iteration.png
