guruITA/smart-city-sim/docs/Wesley/assets/Traffic Light - first iterion - fritzing/traffic lights - first iteration - breadboard.png

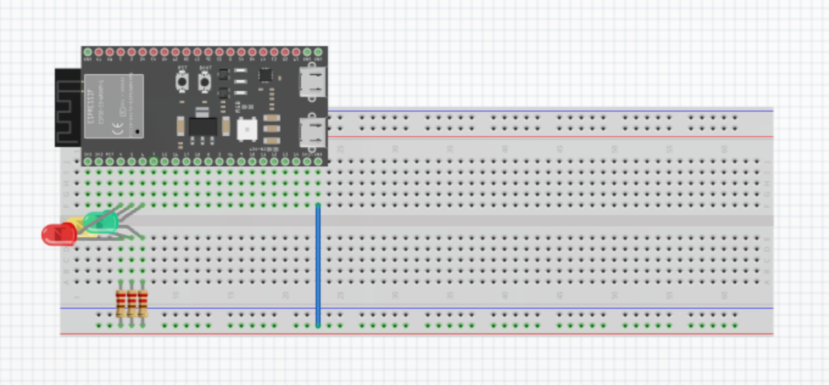
docs/Wesley/assets/Traffic Light - first iterion - fritzing/traffic lights - first iteration - breadboard.png
