guruITA/smart-city-sim/docs/Wesley/assets/Traffic Light - first iterion - fritzing/traffic lights - first iteration - schematic.png

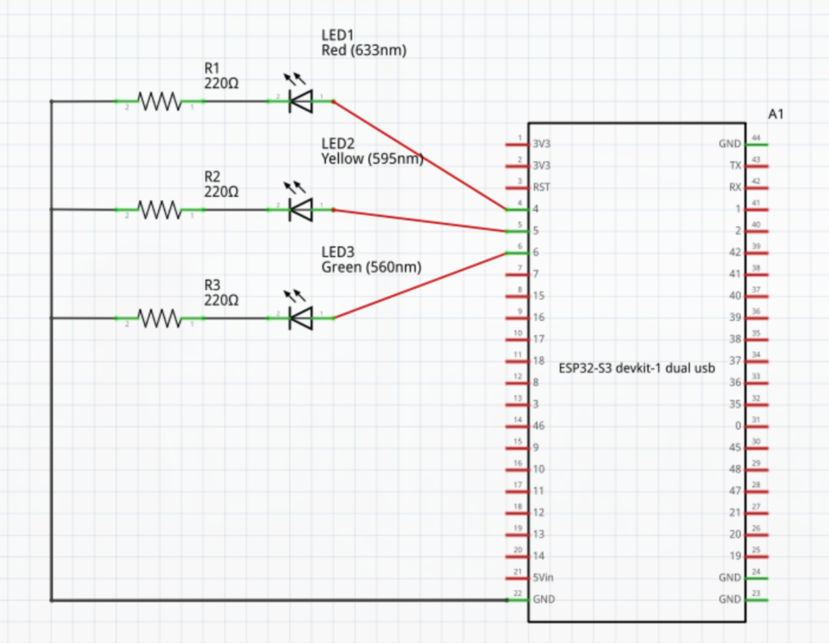
docs/Wesley/assets/Traffic Light - first iterion - fritzing/traffic lights - first iteration - schematic.png
