guruITA/smart-city-sim/docs/Wesley/learning outcomes/sprint 2/image.png

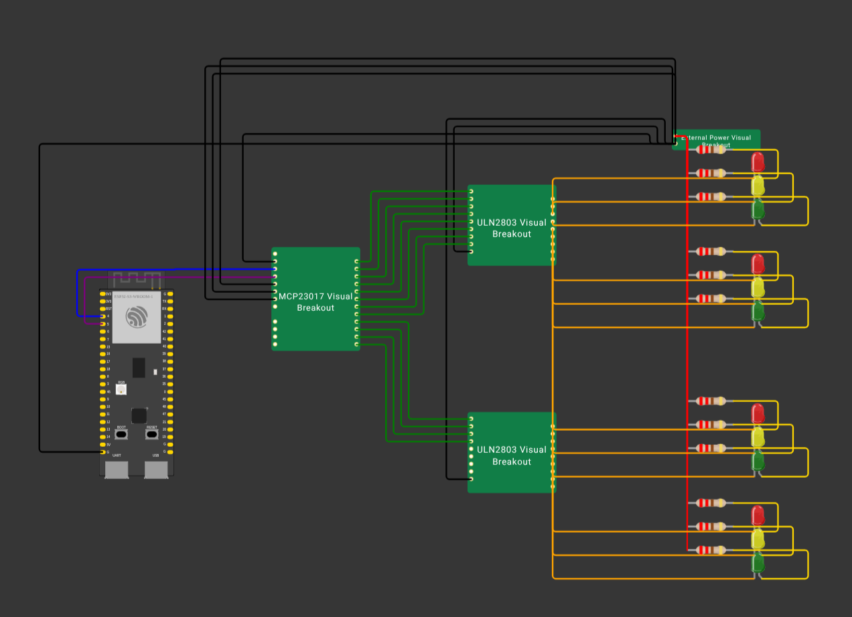
docs/Wesley/learning outcomes/sprint 2/image.png
