guruITA/smart-city-sim/docs/Gurpreet/Learning goals/Design/Sprint 3/images/BOM.png

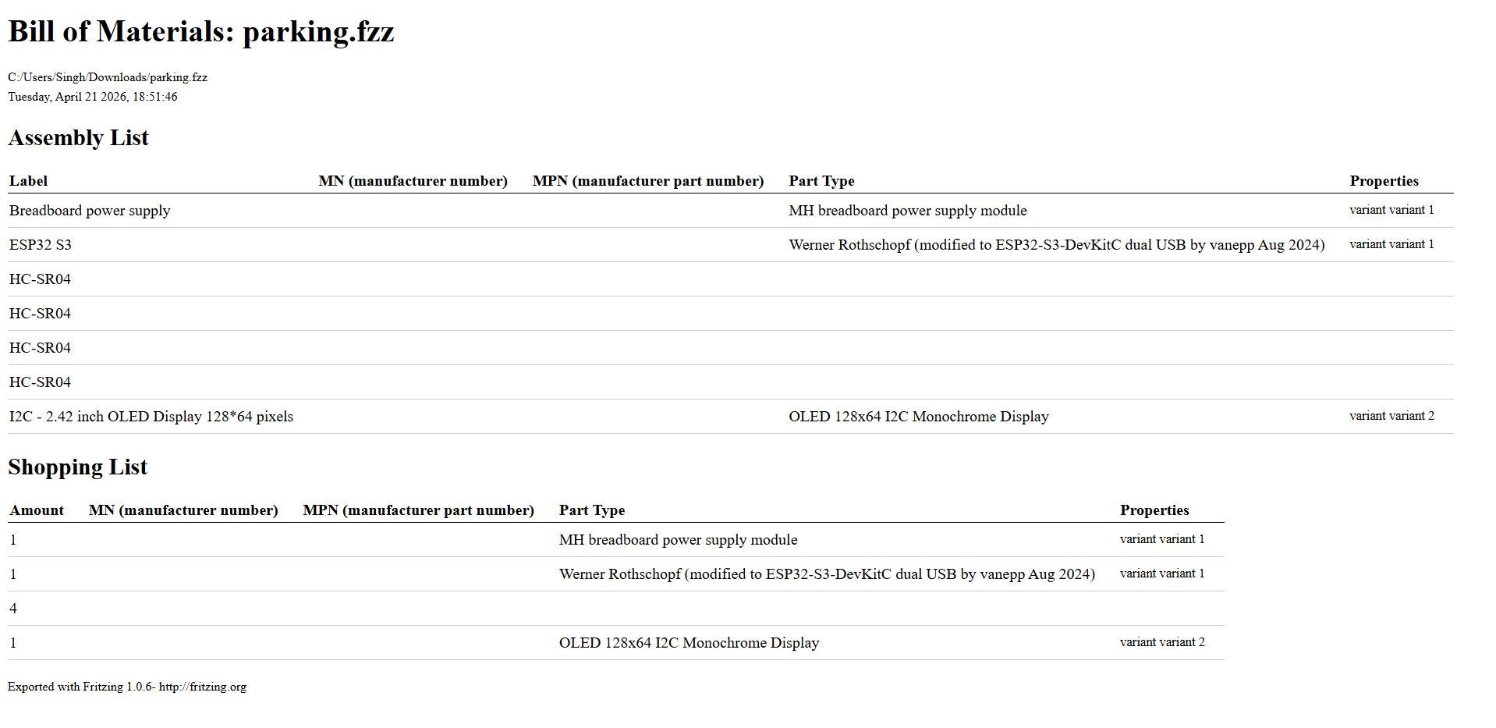
docs/Gurpreet/Learning goals/Design/Sprint 3/images/BOM.png
