guruITA/smart-city-sim/docs/Wesley/assets/ESP32-S3 Development Board - Pinout, Interfaces, and Practical Board Comparison/figure01_components.png

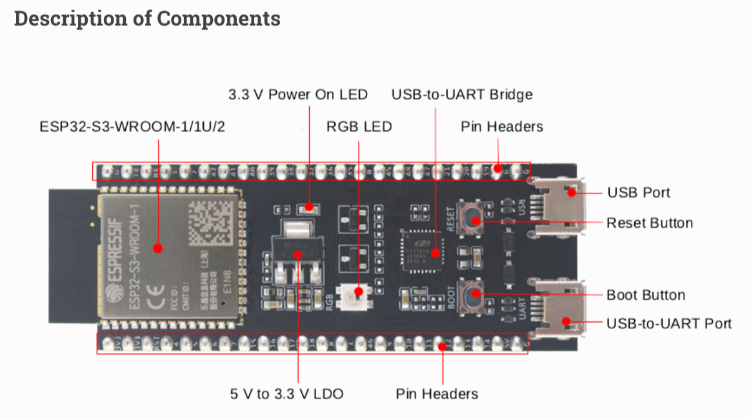
docs/Wesley/assets/ESP32-S3 Development Board - Pinout, Interfaces, and Practical Board Comparison/figure01_components.png
