guruITA/smart-city-sim/docs/Gurpreet/Learning goals/Learning journey/Sprint 1/Proof/images/parallel_led_wiring_with_resistors.png

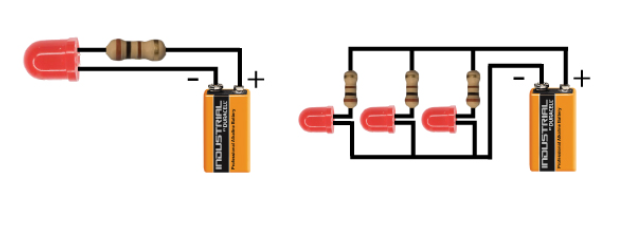
docs/Gurpreet/Learning goals/Learning journey/Sprint 1/Proof/images/parallel_led_wiring_with_resistors.png
