guruITA/smart-city-sim/docs/Gurpreet/Learning goals/Learning journey/Sprint 1/Proof/images/clone_5v_pin_issue.png

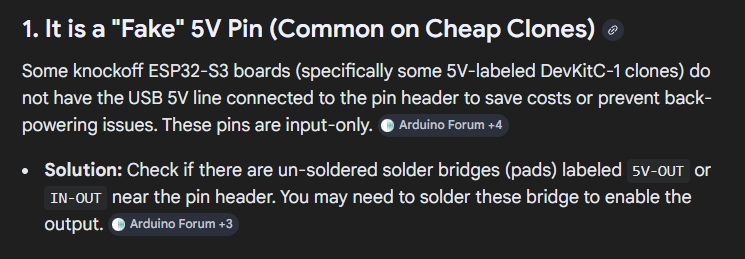
docs/Gurpreet/Learning goals/Learning journey/Sprint 1/Proof/images/clone_5v_pin_issue.png
