guruITA/smart-city-sim/(list of files, drawings)

Other design files:
docs/Wesley/learning outcomes/sprint 4/design-files/Traffic lights with chips_v3 perf board.fzz
