guruITA/smart-city-sim/embedded/Gurpreet/speed_camera/speed_camera_s3/speed_camera_s3.ino

#include <Wire.h>
#include <WiFi.h>
#include <Adafruit_GFX.h>
#include <Adafruit_SSD1306.h>

#define IR1_PIN 6
#define IR2_PIN 12
#define OLED_SDA_PIN 17
#define OLED_SCL_PIN 46

#define SCREEN_WIDTH 128
#define SCREEN_HEIGHT 64
#define OLED_ADDR 0x3C

#define IR_ACTIVE_STATE LOW

#define SENSOR_DISTANCE_M 0.10f
#define SPEED_LIMIT_KMH 1.0f

#define PASS_TIMEOUT_US 2000000UL
#define MEASUREMENT_COOLDOWN_MS 500
#define RESULT_SCREEN_HOLD_MS 2000

const char* CAM_WIFI_SSID = "ESP32CAM_CAPTURE";
const char* CAM_WIFI_PASS = "12345678";
const char* CAM_IP = "192.168.4.1";
const uint16_t CAM_PORT = 80;

TwoWire speedCameraWire = TwoWire(0);
Adafruit_SSD1306 display(SCREEN_WIDTH, SCREEN_HEIGHT, &speedCameraWire, -1);
bool displayReady = false;

enum MeasureState { IDLE, WAIT_FOR_SECOND_SENSOR };

MeasureState measureState = IDLE;
int firstSensor = 0;
unsigned long tStartUs = 0;

bool lastIr1Active = false;
bool lastIr2Active = false;

float lastSpeedKmh = 0.0f;
bool lastTooFast = false;
String lastDirection = "-";
unsigned long lastEventMs = 0;
unsigned long lastMeasurementDoneMs = 0;

unsigned long lastUiRefresh = 0;

bool sensorActive(int pin) {
  return digitalRead(pin) == IR_ACTIVE_STATE;
}

void connectToCamWiFi() {
  WiFi.mode(WIFI_STA);
  WiFi.begin(CAM_WIFI_SSID, CAM_WIFI_PASS);

  unsigned long startAttempt = millis();

  while (WiFi.status() != WL_CONNECTED && millis() - startAttempt < 15000) {
    delay(500);
    Serial.print(".");
  }
}

bool ensureWiFiConnected() {
  if (WiFi.status() == WL_CONNECTED) {
    return true;
  }

  WiFi.disconnect();
  WiFi.begin(CAM_WIFI_SSID, CAM_WIFI_PASS);

  unsigned long startAttempt = millis();
  while (WiFi.status() != WL_CONNECTED && millis() - startAttempt < 5000) {
    delay(250);
    Serial.print(".");
  }

  return WiFi.status() == WL_CONNECTED;
}

void triggerCameraOverWiFi() {

  if (!ensureWiFiConnected()) {
    return;
  }

  WiFiClient client;

  if (!client.connect(CAM_IP, CAM_PORT)) {
    return;
  }

  client.print(String("GET /capture HTTP/1.1\r\n") + "Host: " + CAM_IP + "\r\n" +
               "Connection: close\r\n\r\n");

  unsigned long timeout = millis();
  while (client.connected() && millis() - timeout < 2000) {
    while (client.available()) {
      String line = client.readStringUntil('\n');
      Serial.println(line);
      timeout = millis();
    }
  }

  client.stop();
}

void drawStatusScreen(bool ir1, bool ir2) {

  display.clearDisplay();
  display.setTextSize(1);
  display.setTextColor(SSD1306_WHITE);
  display.setCursor(0, 0);

  display.println("Speed Camera S3");
  display.println("----------------");

  display.print("IR1: ");
  display.println(ir1 ? "ACTIVE" : "REST");

  display.print("IR2: ");
  display.println(ir2 ? "ACTIVE" : "REST");

  display.print("Last: ");
  display.print(lastSpeedKmh, 1);
  display.println(" km/u");

  display.print("Limit: ");
  display.print(SPEED_LIMIT_KMH, 1);
  display.println(" km/u");

  display.print("Direction: ");
  display.println(lastDirection);

  if (WiFi.status() == WL_CONNECTED) {
    display.println(WiFi.localIP().toString().c_str());
  } else {
    display.println("WiFi: offline");
  }

  display.display();
}

void drawMeasurementScreen(float speedKmh, bool tooFast, const String& direction,
                           unsigned long dtUs) {

  display.clearDisplay();
  display.setTextSize(1);
  display.setTextColor(SSD1306_WHITE);
  display.setCursor(0, 0);

  display.println("MEASUREMENT READY");
  display.println("------------");

  display.print("Direction: ");
  display.println(direction);

  display.print("Time: ");
  display.print(dtUs / 1000.0f, 1);
  display.println(" ms");

  display.print("Speed: ");
  display.print(speedKmh, 1);
  display.println(" km/u");

  display.print("Limit: ");
  display.print(SPEED_LIMIT_KMH, 1);
  display.println(" km/u");

  if (tooFast) {
    display.println("Result: TOO FAST!");
  } else {
    display.println("Result: OK");
  }

  display.display();
}

void resetMeasurement() {
  measureState = IDLE;
  firstSensor = 0;
  tStartUs = 0;
}

void processMeasurement(int fromSensor, int toSensor, unsigned long dtUs) {
  if (dtUs == 0) {
    resetMeasurement();
    return;
  }

  float dtSeconds = dtUs / 1000000.0f;
  float speedMs = SENSOR_DISTANCE_M / dtSeconds;
  float speedKmh = speedMs * 3.6f;
  bool tooFast = speedKmh > SPEED_LIMIT_KMH;

  lastSpeedKmh = speedKmh;
  lastTooFast = tooFast;
  lastDirection = (fromSensor == 1 && toSensor == 2) ? "1->2" : "2->1";
  lastEventMs = millis();
  lastMeasurementDoneMs = millis();

  drawMeasurementScreen(speedKmh, tooFast, lastDirection, dtUs);

  if (tooFast) {
    triggerCameraOverWiFi();
  }

  resetMeasurement();
}

void setup() {
  Serial.begin(115200);
  delay(300);

  pinMode(IR1_PIN, INPUT);
  pinMode(IR2_PIN, INPUT);

  speedCameraWire.begin(OLED_SDA_PIN, OLED_SCL_PIN);

  display.begin(SSD1306_SWITCHCAPVCC, OLED_ADDR);

  connectToCamWiFi();

  drawStatusScreen(false, false);

  lastIr1Active = sensorActive(IR1_PIN);
  lastIr2Active = sensorActive(IR2_PIN);
}

void loop() {
  bool ir1 = sensorActive(IR1_PIN);
  bool ir2 = sensorActive(IR2_PIN);

  bool edge1 = ir1 && !lastIr1Active;
  bool edge2 = ir2 && !lastIr2Active;

  bool inCooldown = (millis() - lastMeasurementDoneMs) < MEASUREMENT_COOLDOWN_MS;

  switch (measureState) {
  case IDLE:
    if (!inCooldown) {
      if (edge1 && !ir2) {
        firstSensor = 1;
        tStartUs = micros();
        measureState = WAIT_FOR_SECOND_SENSOR;
      } else if (edge2 && !ir1) {
        firstSensor = 2;
        tStartUs = micros();
        measureState = WAIT_FOR_SECOND_SENSOR;
      }
    }
    break;

  case WAIT_FOR_SECOND_SENSOR: {
    unsigned long elapsedUs = micros() - tStartUs;

    if (elapsedUs > PASS_TIMEOUT_US) {
      resetMeasurement();
    } else if (firstSensor == 1 && edge2) {
      processMeasurement(1, 2, elapsedUs);
    } else if (firstSensor == 2 && edge1) {
      processMeasurement(2, 1, elapsedUs);
    }
    break;
  }
  }

  if (millis() - lastUiRefresh > 150) {
    if ((millis() - lastEventMs) >= RESULT_SCREEN_HOLD_MS) {
      drawStatusScreen(ir1, ir2);
    }
    lastUiRefresh = millis();
  }

  lastIr1Active = ir1;
  lastIr2Active = ir2;
}
