guruITA/smart-city-sim/embedded/city-sim/city-sim.ino

#include "Config.h"
#include "NetworkController.h"
#include "Streetlight.h"
#include "TrainPredictionSignal.h"
#include "EinkDisplay.h"
#include "SpeedCamera.h"
#include "Parking.h"

#define builtin LED_BUILTIN

StreetLight lamp(
  Config::Streetlight::LDR_PIN,
  Config::Streetlight::RELAY_PIN,
  Config::Streetlight::THRESHOLD,
  Config::Streetlight::INTERVAL_MS
);

SpeedCamera speedCamera(Config::SpeedCamera::IR1_PIN, Config::SpeedCamera::IR2_PIN,
                        Config::SpeedCamera::OLED_SDA_PIN, Config::SpeedCamera::OLED_SCL_PIN,
                        Config::SpeedCamera::SCREEN_WIDTH, Config::SpeedCamera::SCREEN_HEIGHT,
                        Config::SpeedCamera::OLED_ADDRESS, Config::SpeedCamera::IR_ACTIVE_STATE,
                        Config::SpeedCamera::SENSOR_DISTANCE_M,
                        Config::SpeedCamera::SPEED_LIMIT_KMH, Config::SpeedCamera::PASS_TIMEOUT_US,
                        Config::SpeedCamera::MEASUREMENT_COOLDOWN_MS,
                        Config::SpeedCamera::RESULT_SCREEN_HOLD_MS,
                        Config::SpeedCamera::BOOT_SCREEN_HOLD_MS,
                        Config::SpeedCamera::UI_REFRESH_INTERVAL_MS);

EinkDisplay eink(
  Config::EinkDisplay::CLK_PIN,
  Config::EinkDisplay::MOSI_PIN,
  Config::EinkDisplay::CS_PIN,
  Config::EinkDisplay::DC_PIN,
  Config::EinkDisplay::RST_PIN,
  Config::EinkDisplay::BUSY_PIN
);

Parking parking(Config::Parking::MCP23017_ADDRESS, Config::Parking::TRIG1_PIN,
                Config::Parking::TRIG2_PIN, Config::Parking::TRIG3_PIN, Config::Parking::TRIG4_PIN,
                Config::Parking::ECHO1_PIN, Config::Parking::ECHO2_PIN, Config::Parking::ECHO3_PIN,
                Config::Parking::ECHO4_PIN, Config::Parking::OLED_SDA_PIN,
                Config::Parking::OLED_SCL_PIN, Config::Parking::SCREEN_WIDTH,
                Config::Parking::SCREEN_HEIGHT, Config::Parking::OLED_ADDRESS,
                Config::Parking::SOUND_SPEED, Config::Parking::PARKED_THRESHOLD_ON_CM,
                Config::Parking::PARKED_THRESHOLD_OFF_CM, Config::Parking::INVALID_DISTANCE_CM,
                Config::Parking::ECHO_TRAVEL_DIVIDER, Config::Parking::ECHO_TIMEOUT_MICROSECONDS,
                Config::Parking::UI_REFRESH_INTERVAL_MS,
                Config::Parking::SENSOR_MEASURE_INTERVAL_MS);

// Railroad crossing tile
TrainPredictionSignal trainSignal(Config::TrainPredictionSignal::LED1_PIN, 
                                  Config::TrainPredictionSignal::LED2_PIN, 
                                  Config::TrainPredictionSignal::BUZZER_PIN, 
                                  Config::TrainPredictionSignal::SERVO_PIN, 
                                  Config::TrainPredictionSignal::BTN_PIN, 
                                  Config::TrainPredictionSignal::AB_DISTANCE, 
                                  Config::TrainPredictionSignal::BC_DISTANCE, 
                                  Config::TrainPredictionSignal::SAFETY_MARGIN, 
                                  Config::TrainPredictionSignal::BUZZER_FREQ, 
                                  Config::TrainPredictionSignal::BUZZER_RESOLUTION, 
                                  Config::TrainPredictionSignal::BARRIER_OPEN_ANGLE, 
                                  Config::TrainPredictionSignal::BARRIER_CLOSED_ANGLE);

void setup() {
  pinMode(builtin, OUTPUT);
  digitalWrite(builtin, LOW);

  Serial.begin(115200);
  Serial.println("Setup start");

  if (NetworkController::begin(Config::Network::WIFI_SSID, Config::Network::WIFI_PASSWORD)) {
    Serial.println("WiFi connected, network fetch availability up");
  } else {
    Serial.println("WiFi not connected, some network features will be skipped");
  }

  NetworkController::setApiBaseUrl(Config::Network::API_BASE_URL);
  lamp.begin();
  eink.begin();
  eink.startSyncTask();
  trainSignal.begin();
  speedCamera.begin();
  parking.begin();
}

void loop() {
  lamp.update();
  trainSignal.update();
  speedCamera.update();
  parking.update();
}
