guruITA/smart-city-sim/(commit log)

2026-02-11 feat: :sparkles: blink the builtin rgb led with random colors and blink another led
2026-02-12 feat(embedded): add first ESP32 blink example using built-in LED
2026-02-12 fix(esp32): remove LED_BUILTIN constant assignment
    [hello-world.ino]
2026-02-14 feat: :sparkles: blink two leds
2026-02-14 refactor: :sparkles: just make it blink the rgb led only and rename file
2026-02-15 feat: :sparkles: made a simple train arrival prediction demo with a LED and a BUTTON
2026-02-17 docs: :memo: documentation of rgb led demo
2026-02-17 docs: :memo: add documentation about the alternating leds demo
2026-02-17 Railway Crossing demo and basic demo's
2026-02-26 feat(streetlight): implement automatic street light system with LDR and relay control
2026-03-03 docs: :memo: add the circuit to the documentation
2026-03-03 Fix logic for streetlight activation and improve serial output messages
    [streetlight.ino]
2026-03-04 fix: increase thresholf from 500 to 650
    [streetlight.ino]
2026-03-05 docs: Added 'My current goal' section with youtube video's references in APA with in text citation
2026-03-05 docs: added finding during reasearch on LED and updated reference with in text citation
2026-03-05 docs: added and expanded LED resistor calculations and explanation with relevant images for clarity
2026-03-05 docs: added explanation of relay module usage and connections for smart streetlight project, updated references with in text citation
2026-03-05 docs: expanded analysis on ESP32-S3 setup for smart streetlight, added relevant images
2026-03-05 docs: added power consumption analysis and relevant images
2026-03-05 docs: format LED specifications
2026-03-09 docs: update analysis.md with power supply decision and add schematic images
2026-03-09 docs: update analysis.md with additional references and safety considerations for power supply
2026-03-10 Added feedback about safety considerations with solutions for power supply
2026-03-10 docs: Added finding on 5V Vin of the esp32-S3
2026-03-10 docs: added explanation for using breadboard with multiple LEDs and resistors
2026-03-10 docs: expanded design document with Fritzing overview and added Smart Streetlight prototype details
2026-03-10 docs: updated breadboard streetlight wiring image
2026-03-11 docs: added advice document and prototype image for Sprint 1
2026-03-11 feat: :sparkles: added servo barrier and removed oled screen
2026-03-11 docs: :memo: update docs for train prediction signal
    added servo functionality to the train prediction signal
2026-03-11 docs: :memo: Power supply mention
2026-03-11 docs: :memo: add new schematic
2026-03-12 docs: add section on possible sensors for the prototype in Problem Analysis
2026-03-12 feat: :sparkles: added a buzzer to act like the bells on a railroad crossing
    added a buzzer to the warning LEDS function
    [train-prediction-signal.ino]
2026-03-12 docs: :memo: update schematic with passive buzzer
2026-03-12 feat: :sparkles: Practice projects
    Added practice projects. These where used to test how I could make use of the ESP32S3
2026-03-13 docs: update capacitor analysis with additional references and added supporting image
2026-03-13 docs: added prototype design explanation
2026-03-13 docs: add final power supply choice for Sprint 1 prototype analysis
2026-03-13 docs: update power supply analysis for Sprint 1 prototype with final recommendations
2026-03-17 docs: :memo: ESP32-S3 documentation
    Documenting ESP32-S3 learnings for:
    - Pinout,
    - Interfaces,
    - Practical Board Comparison
2026-03-18 docs: update advice report with detailed comparison of relay and MOSFET solutions
2026-03-19 fix: :bug: Bug led stayed on
    Fix led stayed on, is now turned of through code
    [traffic_light.ino]
2026-03-23 feat: :sparkles: add railroad crossing tables to the database
2026-03-23 feat: :sparkles: add railroad crossing schema's
2026-03-24 feat: :sparkles: make train endpoints for specific sensors and getters
2026-03-24 feat: :lipstick: using Animation frames to make smooth line animation
2026-03-24 feat: add ESP32-CAM photo capture functionality
2026-03-24 feat: add speed camera functionality with OLED display and IR sensors
2026-03-25 Speeding camera
2026-03-26 fix esp32-s3 pictures in the document
2026-03-26 feat: :sparkles: Add configuration files for speed camera, streetlight, and hello-world profiles
2026-03-30 Fix: Added viewed date to Arduino library documentation source
2026-03-30 docs: :memo: Api current usage and upcoming api usage
2026-04-01 docs: added new design and prototype files for Sprint 2
2026-04-01 refactor: remove unused trigger pin and related logic; enhance AP startup logging
2026-04-01 feat: implement WiFi connectivity for camera triggering; remove hardware trigger logic
2026-04-02 docs: added initial prototype documentation for smart pedestrian crossing subsystem
2026-04-02 refactor: :bug: fix lights problem
    [city-sim.ino]
2026-04-02 feat: :art: Moved esp32 cam logic into a seperate project as a library
2026-04-03 feat: :sparkles: added the esp32s3 side of the logic for the speeding camera
2026-04-03 feat: Added speed camera logig (it works but currently still improving it)
2026-04-03 docs: add analysis section for ESP32 standalone operation in smart pedestrian crossing system
2026-04-07 docs: :memo: Added Fritzing design, schematic, BoM
2026-04-08 feat: :sparkles: implement TrainPredictionSignal functionality with HTTP requests and button handling
2026-04-08 feat: :sparkles: I2C scanner
    I2C scanner
2026-04-09 fix: :bug: was wrong order for Port A, top ULN2803
    was wrong order for Port A, top ULN2803
    [crossroad_traffic_light.ino]
2026-04-12 docs: add results and reflections for smart pedestrian crossing prototype implementation
2026-04-12 docs: add detailed prototype documentation for pedestrian crossing system
2026-04-13 docs: add advice on using header files for GPIO pin definitions in ESP32-S3 project
2026-04-14 feat(Parking): implement parking sensor functionality with OLED display
2026-04-14 refactor(speed-camera): add boot screen timing state to header
2026-04-14 refactor(speed-camera): replace startup delay with millis logic
2026-04-15 refactor: removed delay from speedcamera logic that was causing issues inside the sity-sim project and working on parking prototype
    [Parking.ino, city-sim.ino]
2026-04-16 fix(Parking): adjust parked threshold for improved detection accuracy
    [Parking.ino]
2026-04-16 fix(Parking): added logic for 3 parking space
    [Parking.ino]
2026-04-16 fix(Parking): added logic for 4 parking space
    [Parking.ino]
2026-04-16 refactor(Parking): replace magic number with UI refresh interval constant
    [Parking.ino]
2026-04-16 refactor(Parking): implement sensor measurement interval for improved efficiency
2026-04-17 refactor(Parking): enhance distance measurement logic and state management for sensors
2026-04-17 refactor(Parking): replace default Wire instance with custom TwoWire for display
    [Parking.ino]
2026-04-17 refactor(Parking): change currentSensorIndex type from int to int8_t for better memory usage
2026-04-17 fix(SpeedCamera): include Wire.h and add displayWire member variable
2026-04-17 fix(SpeedCamera): update display initialization to use displayWire and correct OLED SDA pin
2026-04-17 fix(Parking): reduce echo timeout for improved sensor responsiveness
2026-04-17 fix(Parking): increase echo timeout for improved sensor accuracy
2026-04-17 refactor(StreetLight): remove debug print statements from begin and update methods
2026-04-17 fix(SpeedCamera): correct OLED SDA pin definition and remove debug print statements
    [speed_camera_s3.ino]
2026-04-17 fix(SpeedCamera): update display initialization to use custom TwoWire instance
    [speed_camera_s3.ino]
2026-04-17 fix(SpeedCamera): remove unnecessary display readiness checks in draw functions
    [speed_camera_s3.ino]
2026-04-20 refactor(esp32cam): rename beginEsp32Cam and updateEsp32Cam to begin and update
2026-04-20 refactor(esp32cam): simplify beginWebServer and rename beginEsp32Cam/updateEsp32Cam to begin/update
2026-04-22 chore: add BOM image for Sprint 3 design goals
2026-04-22 docs: :memo: Add analysis document for sprint 3 goal: E-ink Display Integration with ESP32
2026-04-22 fix: :bug: added missing value
    [city-sim.ino]
2026-04-23 fix: adjust sensor measurement interval for improved responsiveness
2026-04-23 fix: remove unnecessary interrupt handling in distance measurement
2026-04-23 fix: cast echo pin values to int8_t for type consistency in Parking constructor
2026-04-23 feat: implement speed camera API, database models, and comprehensive project documentation
2026-04-24 fix: add comments for attachInterrupt and detachInterrupt usage in updateDistanceMeasurement
2026-04-24 docs: :memo: Realise documentation - Realised prototype setup
    Realise documentation - Realised prototype setup
2026-04-24 fix: :bug: uncomment SpeedCamera initialization and update calls
    [city-sim.ino]
2026-04-29 feat: Add realise documentation for smart parking occupancy detection system using ESP32-S3
2026-04-29 feat: Add advise documentation for smart parking occupancy detection using ESP32-S3
2026-05-04 fix: Remove duplicate speedCamera initialization in setup and loop functions
    [city-sim.ino]
2026-05-04 fix: Update camera configuration for improved image quality
2026-05-05 refactor: :art: Added Network configuration values to config and moved ESP32 CAM own WIFI to the SpeedCamera configuration
2026-05-05 fix: :bug: Update SpeedCamera configuration values for accurate sensor distance, speed limit, and pass timeout
2026-05-05 fix: :bug: Reduce CAMERA_WIFI_CONNECT_TIMEOUT_MS from 8000 to 3000 for faster connection
2026-05-05 feat: :sparkles: Add CameraTriggerState enum and related methods for enhanced camera control over WiFi
2026-05-05 feat: :sparkles: Implement camera trigger management over WiFi with state handling and backend updates
2026-05-05 feat: ✨ Add E-ink sync functionality
2026-05-06 fix: :bug: Update API base URL configuration to use the defined constant from Config
    [city-sim.ino]
2026-05-06 fix: :bug: Add missing newline at end of file in city-sim.ino
    [city-sim.ino]
2026-05-06 feat: add Traffic model for traffic sensor data
2026-05-06 fix: :bug: Update estimated price for HC-SR04 ultrasonic sensor in design document
2026-05-06 fix: :bug: Update link for ESP32-S3 component in bill of materials and remove unnecessary fritzing BOM pic
2026-05-06 fix: :bug: Update version number to 2.0 in design document for smart parking occupancy detection and update BOM
2026-05-06 fix: :bug: Correct formatting of DuPont Jumper wire entry in bill of materials
2026-05-06 fix: :bug: Update bill of materials format and add component specifications for clarity
2026-05-06 fix: :bug: Correct wiring notation for OLED SCL in design documentation
2026-05-07 feat: :sparkles: vehicle detection ky-021 sensor ino test file
    vehicle detection ky-021 sensor ino test file, tested working on ESP32-S3
2026-05-07 feat: :sparkles: ESP32 testing httpbin connection, imports
    ESP32 testing httpbin connection, imports
2026-05-07 feat: :sparkles: ESP32 testing httpbin connection, wifi settings
    ESP32 testing httpbin connection, wifi settings
2026-05-07 feat: :sparkles: ESP32 testing httpbin connection, test timing
    ESP32 testing httpbin connection, test timing
2026-05-07 feat: :sparkles: ESP32 testing httpbin connection, message testing
    ESP32 testing httpbin connection, Simulated traffic states for backend-message testing
2026-05-07 feat: :sparkles: ESP32 testing httpbin connection, printHeader
    ESP32 testing httpbin connection, printHeader
2026-05-07 feat: :sparkles: ESP32 testing httpbin connection, printWiFiStatus
    ESP32 testing httpbin connection, printWiFiStatus
2026-05-07 feat: :sparkles: ESP32 testing httpbin connection, connectToWiFi
    ESP32 testing httpbin connection, connectToWiFi
2026-05-07 feat: :sparkles: crossroad with sensor, imports, wifi, and backend settings
    crossroad with sensor
    - added imports, wifi, and backend settings,
2026-05-07 feat: :sparkles: crossroad with sensor, sensor and I2C settings, pins
    crossroad with sensor, added:
    - sensor settings and I2C settings,
    - MCP23017 registers,
    - Output mapping
2026-05-07 feat: :sparkles: crossroad with sensor, updated
    - Timing values
    - Phase constants
    - State variables
    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
2026-05-07 feat: :sparkles: crossroad with sensor, updated
    - Sensor state variables
    - MCP23017 functions
    - Sensor functions
    - Wi-Fi functions
    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
2026-05-07 feat: :sparkles: crossroad with sensor, updated
    - Traffic-light output functions
    - Backend message functions
    - State machine functions
    - Main loop
    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
2026-05-07 feat: :sparkles: crossroad with sensor v2 with health check
    crossroad with sensor v2:
    - added health check and used placeholder for when endpoint exists
2026-05-07 fix: :bug: traffic light bug fix andmerge conflict resolved
    [I2C_scanner.ino, Parking.ino, crossroad_traffic_light.ino, parking.ino, pedestrian_crossing.ino]
2026-05-11 docs: add Sprint 2 portflow documents (3 learning goals + 5 deliverables)
    Restructured portflowEvidenceSprint2.md into per-challenge format:
    - LG1: Production deployment on Raspberry Pi (Design + Realise)
    - LG2: Merge conflicts and code integration (Realise)
    - LG3: Team integration analysis (Analysis + Advise)
2026-05-11 docs: update architecture SVG and system-architecture for current state
    New SVG with 5 tiles, 7 routers, 6 tables, port 80, Pi IP.
    system-architecture.md rewritten with DB evolution table and all routers.
2026-05-12 feat: :sparkles: Add advice document for smart parking occupancy detection using ESP32-S3, including sensor recommendations and scalability considerations
2026-05-14 fix: :bug: Refactor Parking class to include MCP23017 for ultrasonic sensor management and update data structure for parking spots
2026-05-14 refactor: :bug: Update Parking class to integrate MCP23017 for sensor management and enhance parking spot data structure
2026-05-14 fix: :bug: Update Parking configuration to integrate MCP23017 and adjust sensor pin assignments and thresholds
2026-05-14 refactor: :bug: Update Parking initialization to integrate MCP23017 address and reorganize trigger pin assignments
    [city-sim.ino]
2026-05-17 docs: :memo: made new improved wiring diagram
2026-05-18 fix: :bug: Update port configuration to COM9 and add Adafruit MCP23017 Arduino Library
2026-05-18 feat: :sparkles: Add analysis document for reducing ESP32-S3 pin usage in smart parking sensors
2026-05-18 fix: :bug: changed endpoint to correct endpoint
    changed endpoint to correct endpoint
    [crossroad_traffic_light_with_sensor_v2.ino]
2026-05-20 feat: :sparkles: Add GPIO pin configuration for parking OLED display
2026-05-20 feat: :sparkles: Add GPIO pin configuration for parking OLED display (SCL pin)
2026-05-20 feat: :sparkles: Add MCP23017 trigger pins for ultrasonic sensors
2026-05-20 feat: :sparkles: Add MCP23017 echo pins for ultrasonic sensors
2026-05-20 feat: :sparkles: Add OLED display dimensions and I2C address for ultrasonic sensor configuration
2026-05-20 feat: :sparkles: Add echo timeout and UI refresh intervals for parking sensor display
2026-05-21 docs: :memo: Made first version of the analysis document for sprint 4
    The purpose of this document is to investigate how the current breadboard implementation can be transformed into a more reliable and professional solution using either a perfboard or a custom PCB design.
2026-05-21 feat: :sparkles: Add advice document for reducing ESP32-S3 pin usage in smart parking sensors
2026-05-21 docs: :memo: analysis sprint 4, introduction
    Analysis sprint 4, added introduction, current situation, and problem definition
2026-05-21 docs: :memo: analysis sprint 4, Requirements for the professionalised circuit
    Analysis sprint 4, added Requirements for the professionalised circuit, and Possible approaches
2026-05-22 refactor: remove redundant comment for ultrasonic sensor trigger pin
2026-05-22 feat: add MCP23017 trigger pin configuration for ultrasonic sensor 1
2026-05-24 feat: :sparkles: Made e-ink only program for a esp32c3
2026-05-25 feat: add CameraRegisterRequest and CameraInfoResponse schemas
2026-05-25 feat: add camera registration and retrieval endpoints
2026-05-25 feat: update WiFi credentials and backend camera register URL in esp32cam.h
2026-05-25 feat: add WiFi connection and camera registration functionality
2026-05-25 feat: simplify CameraTriggerState enum by removing unused states
2026-05-25 feat: streamline camera trigger process by updating state management and removing redundant WiFi handling
2026-05-25 docs: :memo: Add pcb 3d images
2026-05-25 docs: :memo: add pcb footprint
2026-05-25 docs: :memo: add perfboard footprint
2026-05-25 docs: :memo: add e-ink schematic
2026-05-26 docs: :memo: Add design document for reducing ESP32-S3 pin usage in scalable smart parking sensors
2026-05-27 docs: :memo: design documentation, KiCad schematic design
    For design documentation of sprint 4, KiCad schematic design
2026-05-27 docs: :memo: design documentation, Purpose of the KiCad schematic
    For design documentation of sprint 4, Purpose of the KiCad schematic
2026-05-27 docs: update current backend situation
2026-05-27 docs: :memo: added lithium battery to BOM and changed design of perfboard
2026-05-27 docs: :memo: changed the design with the new JST connector
2026-05-27 docs: :memo: Update bill of materials with revised component prices for ESP32-S3 project
2026-05-27 docs: :memo: Enhance analysis on ESP32-S3 pin usage by detailing team challenges and solution criteria
2026-05-27 refactor: remove unused camera configuration parameters from Config.h
2026-05-27 refactor: remove unused CAMERA_CAPTURE_URL parameter from SpeedCamera initialization
2026-05-27 refactor: rename CameraTriggerState to CameraCaptureState and update related methods
2026-05-28 docs: :memo: design documentation, KiCad software version and file location
    For design documentation of sprint 4, KiCad software version and file location
2026-05-28 docs: :memo: design documentation, Schematic page setup
    For design documentation of sprint 4, Schematic page setup
2026-05-28 docs: :memo: design documentation, Power and ground symbols
    For design documentation of sprint 4, Power and ground symbols
2026-05-28 docs: :memo: design documentation, ESP32-S3 to MCP23017 schematic design
    For design documentation of sprint 4, ESP32-S3 to MCP23017 schematic design
2026-05-28 docs: :memo: design documentation, MCP23017 to ULN2803 schematic design
    For design documentation of sprint 4, MCP23017 to ULN2803 schematic design
2026-05-28 docs: :memo: design documentation, ULN2803 low-side switching design
    For design documentation of sprint 4, ULN2803 low-side switching design
2026-05-28 docs: :memo: design documentation, Traffic-light connector schematic
    For design documentation of sprint 4, Traffic-light connector schematic
2026-05-28 docs: :memo: Design documentation
    For design documentation of sprint 4, Design documentation, images, fritzing file
    [Traffic lights with chips_v3 perf board.fzz]
2026-05-29 Edit Realise - Speed camera API implementation.md
2026-05-30 feat: add backend override (emergency corridor) as Sprint 4 surprise feature
    Add an override capability so the backend can overrule an individual hub, as
    the back-end brief requires (set all traffic lights red for an emergency
    vehicle). New overrides table, schemas, and an override router with a one-call
    emergency endpoint, plus a standard-library flow test. The change is additive
    and breaks no existing endpoint. Includes the LG3 Design and Realise documents.
2026-05-30 Fix:flow image
2026-06-01 docs: 📝 Realise smart parking
2026-06-01 feat: :sparkles: add kicad source files to repo
2026-06-02 docs: add Realisation Report for Local HTTPS/TLS Prototype Test
2026-06-02 docs: update Realisation with implementation context for HTTPS/TLS prototype test
2026-06-02 docs: add prototype setup
2026-06-02 refactor: :zap: Made the e-ink code ready for the esp32c3 setup
2026-06-02 test: add one-shot Pi test runner for Sprint 4 learning goals
    Runs the LG1 (load, recovery, optional soak), LG2 (backup, restore-verify,
    freshness check) and LG3 (override flow) tests in sequence and writes one
    timestamped results file grouped per Realise document, so the numbers can be
    pasted straight into the Sprint 4 Realise tables once the Pi is connected.
2026-06-03 docs: fill Sprint 4 Realise test results from Pi run
    Ran all Sprint 4 tests on the Raspberry Pi (2026-06-03) with the clustered
    stack running next to the live backend, so the team had no downtime.
    - LG1 clustering: load (0 errors), 5-min soak (no memory leak, RSS flat ~79MB),
    failover ~0.02s, crash auto-restart ~1s via restart policy (both inside the
    5s target). Documented the failover-vs-restart nuance (docker kill bypasses
    restart policy by design; a real non-zero exit is auto-restarted).
    - LG2 backup: dump + restore-verify with exact row counts (183/4), freshness
    guards fail correctly on too-old/too-small, tier-2 off-Pi copy works.
    - LG3 override: end-to-end emergency flow ALL PA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
2026-06-03 feat: add emergency override panel to dashboard and document override
    - dashboard (static/index.html): Emergency Override panel with an emergency
    corridor button (all traffic red), a clear-all button, a generic
    force-command form (any target/command), and a live list of active
    overrides that polls every 2s. Lets the surprise be demoed from the UI
    without depending on a tile.
    - api-specification.md: document the five override endpoints and the panel.
    - database-schema.md: add the overrides and traffic tables, fix the table
    count to seven.
    - LG3 Realise: record that Wesley's tile was down, so the dashboard panel is
    the user-facing demo; also verified the override works on a non-tra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
2026-06-03 feat: rebuild dashboard as city command center with per-hub override
    Redesign the operator dashboard into a mission-control command center where
    the backend override is the hero, telling the demo story: one backend
    commands the whole city. Adds per-hub override preset buttons for every tile
    (traffic, barrier, streetlight, parking, e-ink) next to the emergency corridor.
    - new visual system: Space Grotesk + JetBrains Mono, warm-dark command
    palette, inline Lucide icons, staggered hub power-on, alert states.
    - all data wiring unchanged: the dashboard <script> block is byte-identical,
    every element id and API endpoint preserved, so every hub still renders
    from the same backend.
2026-06-03 feat: restyle dashboard as Amsterdam De Stijl control board
    Replace the generic dark command-center look with a distinctive Dutch
    neo-plastic (De Stijl) civic board: warm paper canvas, heavy black
    structural grid, Mondrian primary accents per hub, Big Shoulders Display
    and Martian Mono type, staggered block power-on on load. Adds a per-target
    command reference list under the custom command bench.
    Visual only: the dashboard <script> stays byte-identical, every element id,
    override hook and API endpoint preserved. Verified responsive at 1440 / 820
    / 390 with headless Chromium.
2026-06-03 fix: align shared backend with merged firmware contracts
    Adopt main's parking and traffic routers so the integrated city-sim firmware
    works against this branch's backend:
    - parking /update now takes is_occupied (the ESP32 decides occupancy) instead
    of distance_cm.
    - traffic POST runs the rule-based decide_traffic_command and returns the
    decision (Wesley's logic).
    Keep this branch's database.py (pool_pre_ping) and the redesigned dashboard.
    Verified live: parking is_occupied, traffic decision, dashboard GETs all respond.
2026-06-03 feat: emergency override forces the whole city, not just traffic
    POST /api/v1/override/emergency now sets an override on every hub at once
    (traffic all_red, barrier close, streetlight force_on, parking full, eink
    show_alert), clearing any earlier active override per target. One button puts
    the entire city into emergency mode. Returns the list of created overrides;
    the dashboard command log shows them. Flow test updated to assert all hubs.
2026-06-03 fix: railroad panel DOM clobber and favicon 404 in dashboard
    refresh() called loadTile on #railroadGrid, overwriting the static #trainId
    and #approachLine nodes that loadApproachingTrains() then wrote to, throwing a
    TypeError every 2s and hiding the approach-line visualisation. That function
    owns the panel, so drop the redundant loadTile call. Add an empty favicon link
    to stop the /favicon.ico 404. Console is now clean.
2026-06-04 fix: update WiFi credentials and backend camera register URL
2026-10-29 docs: cover the prototype sketches and K3s without a Pi, fix what broke
    - README: how to build the personal prototype sketches (generic ESP32-S3,
    core 3.3.7) with a table of what each one is and which libraries it needs,
    and how to try the K3s setup on a laptop with k3d.
    - train-prediction-signal: remove the duplicate ESP32Servo include and
    Servo declaration left by a merge; the sketch did not compile.
    - backend/k8s/README.md: step 4 started with `cd backend` while step 3
    leaves you in backend/k8s; it now goes `cd ..`.
    - Remove the GitHub-to-GitLab mirror workflow: this GitHub copy is now the
    working repository.
2026-10-29 docs: make the README work on Windows and point the backend README to it
    - Step 4 has a PowerShell version: Windows blocks the activate script by
    default, so it is allowed for that window only, and each command is on
    its own line because PowerShell 5 does not know &&.
    - The example requests can be pasted into Bruno or Postman, which is the
    easy way on Windows, where PowerShell has its own curl.
    - The tests note that Windows uses py instead of python3, and 127.0.0.1
    instead of localhost, which waits 5 seconds per request there.
    - backend/README.md was out of date (port 8000, an old parking example) and
    now points to the main README.
    - .venv/ is ignored, so the docs environment does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
