guruITA/smart-city-sim/docs/Wesley/assets/Sprint 3/Realise - Recognizing when a car is waiting at the traffic light and sending that information to the backend/top.jpg

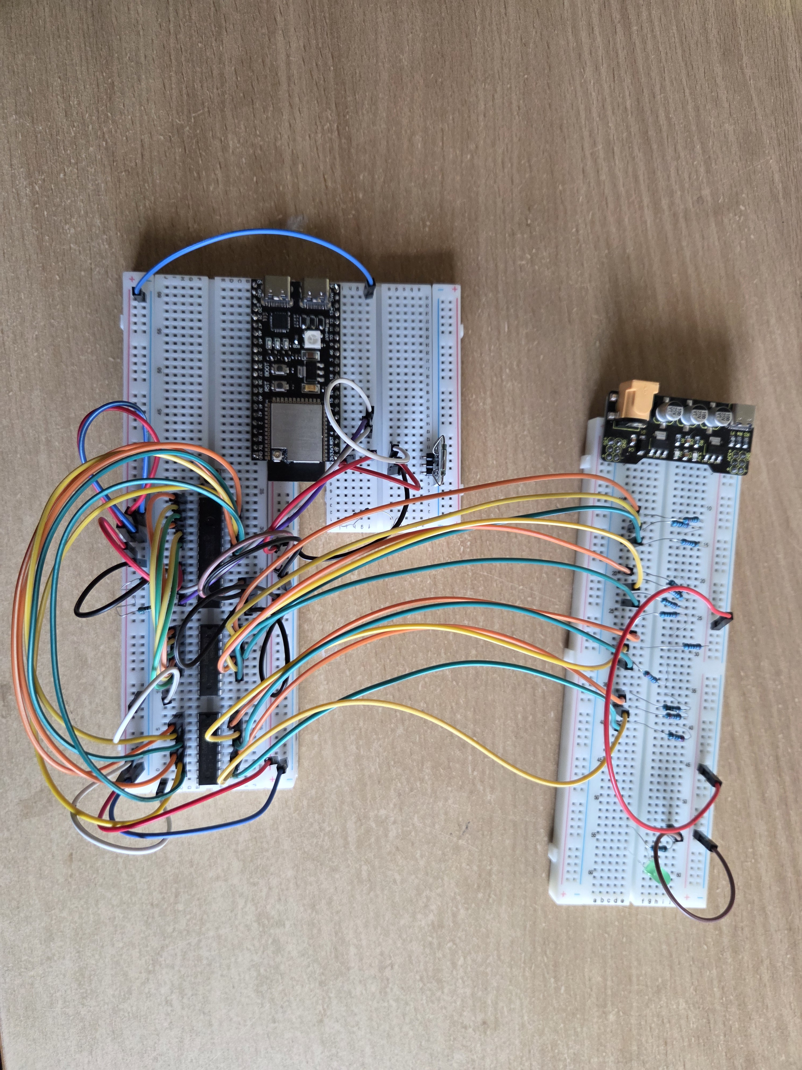
[picture p34: docs/Wesley/assets/Sprint 3/Realise - Recognizing when a car is waiting at the traffic light and sending that information to the backend/top.jpg]
docs/Wesley/assets/Sprint 3/Realise - Recognizing when a car is waiting at the traffic light and sending that information to the backend/top.jpg
